samin50/MEngFYP/.kanbn/index.md

---
startedColumns:
  - 'In Progress'
completedColumns:
  - Done
defaultTaskWorkload: 0
taskWorkloadTags:
  Trivial: 0
  Tiny: 1
  Small: 2
  Medium: 3
  Large: 5
  Huge: 8
---

# Project Organisation

## Blocked

- [create-component-grouper](tasks/create-component-grouper.md)
- [create-component-value-identifier](tasks/create-component-value-identifier.md)
- [create-vision-system](tasks/create-vision-system.md)

## Todo

- [gather-components-training-data](tasks/gather-components-training-data.md)
- [design-new-camera-mount](tasks/design-new-camera-mount.md)

## In Progress

- [interim-report](tasks/interim-report.md)
- [create-conveyor-belt](tasks/create-conveyor-belt.md)
- [design-lcd-ui](tasks/design-lcd-ui.md)

## Done

- [build-stage-1-system](tasks/build-stage-1-system.md)
- [design-camera-mount](tasks/design-camera-mount.md)
- [design-lcd-mount](tasks/design-lcd-mount.md)
- [design-psu-mount](tasks/design-psu-mount.md)
- [determine-necessary-components](tasks/determine-necessary-components.md)
- [talk-with-lab-technicians](tasks/talk-with-lab-technicians.md)
- [create-vision-trainer](tasks/create-vision-trainer.md)
