samin50/MEngFYP/doc/Final Report/Appendix.tex

\newpage
\section{Appendix}
\label{sec:appendix}
\subsection{GitHub Repository}
\label{app:github}
The code and design files for this project can be found at the following link: \\
\url{https://github.com/samin50/MEngFYP}

\subsection{Raspberry Pi Benchmarking}
\begin{figure}[H]
  \centering
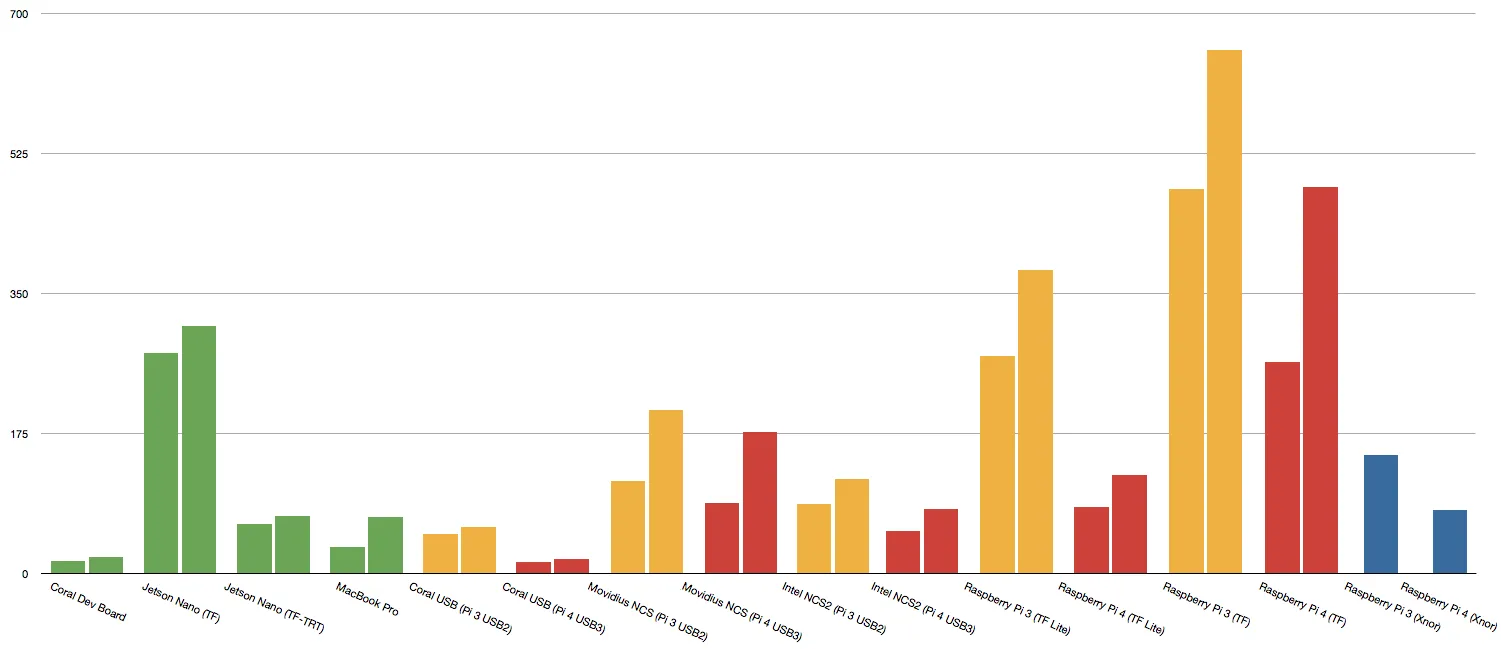
[picture p27: doc/Final Report/imgs/articles/benchmarks.png]
  
  \caption{Raspberry Pi Benchmarking}
  \label{app:benchmarking}
\end{figure}

\subsection{Component Detection Mosaic}
\begin{figure}[H]
  \centering
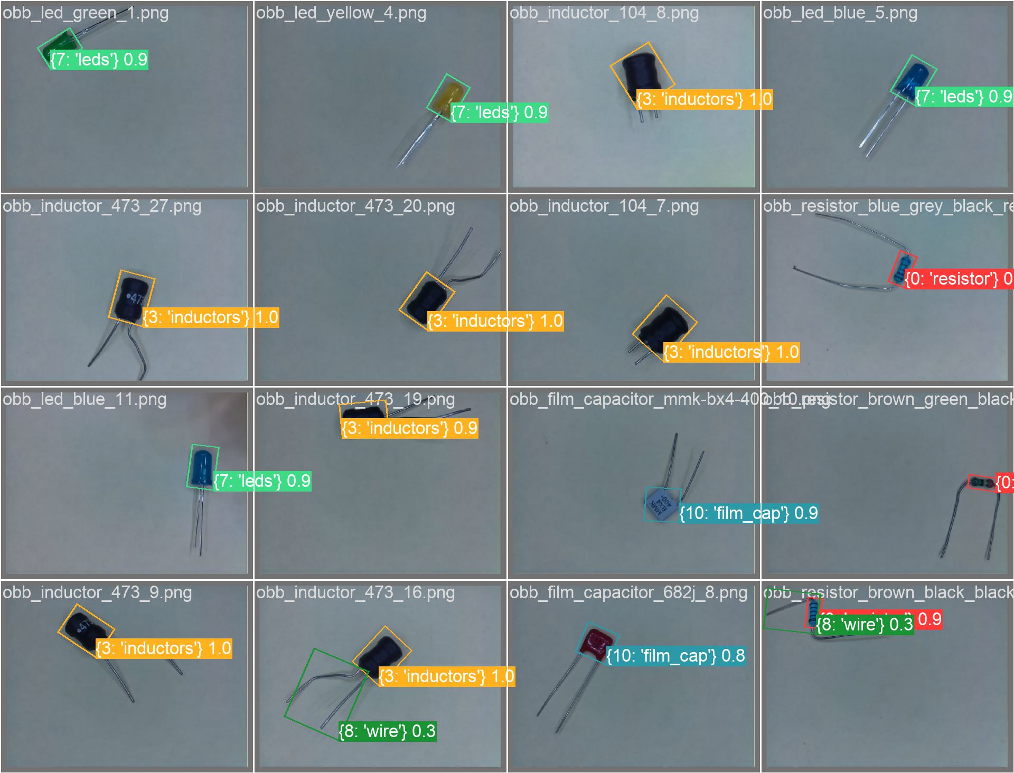
[picture p28: doc/Final Report/imgs/cv/val_batch1_pred.jpg]
  
  \caption{Component Detection Mosaic}
  \label{app:mosaic}
\end{figure}
