samin50/MEngFYP/.kanbn/tasks/design-camera-mount.md

---
created: 2023-12-18T02:33:51.351Z
updated: 2024-02-12T05:19:56.893Z
assigned: ""
progress: 1
tags:
  - 'Stage 1'
  - HME
  - Small
started: 2023-12-16T00:00:00.000Z
completed: 2023-12-18T00:00:00.000Z
---

# Design Camera Mount

Design the camera mount, contains the camera itself and the light ring.

## Relations

- [Succeeded by design-new-camera-mount](design-new-camera-mount.md)
