samin50/MEngFYP/.kanbn/tasks/design-lcd-mount.md

---
created: 2024-01-27T21:05:32.985Z
updated: 2024-02-12T05:20:50.158Z
assigned: ""
progress: 1
tags:
  - 'Stage 1'
  - HME
  - Small
started: 2023-12-18T00:00:00.000Z
completed: 2024-01-04T00:00:00.000Z
---

# Design LCD Mount
