samin50/MEngFYP/.kanbn/tasks/design-lcd-ui.md

---
created: 2024-02-13T02:04:30.207Z
updated: 2024-02-13T02:07:16.027Z
assigned: ""
progress: 0.4
tags:
  - 'All Stages'
  - Software
  - Huge
started: 2023-12-03T00:00:00.000Z
---

# Design LCD UI

Design the UI for the LCD

## Sub-tasks

- [x] Implement camera feed
- [x] System statistics
- [ ] Computer vision overlay
- [ ] Hardware control section

## Relations

- [Requires create-vision-system](create-vision-system.md)
