samin50/MEngFYP/.kanbn/tasks/design-new-camera-mount.md

---
created: 2024-02-12T03:16:14.948Z
updated: 2024-02-12T16:56:02.773Z
assigned: ""
progress: 0
tags:
  - 'Stage 2'
  - HME
  - Small
started: 2024-02-01T00:00:00.000Z
---

# Design New Camera Mount

Design the camera mount for the stage 2 conveyor belt system.

## Sub-tasks

- [ ] Design face-down mount
- [ ] Wire camera

## Relations

- [Requires create-conveyor-belt](create-conveyor-belt.md)
- [Replaces design-camera-mount](design-camera-mount.md)
