samin50/MEngFYP/.kanbn/tasks/design-psu-mount.md

---
created: 2024-01-27T21:03:12.771Z
updated: 2024-02-12T05:20:02.635Z
assigned: ""
progress: 1
tags:
  - 'Stage 1'
  - HME
  - Medium
started: 2023-12-18T00:00:00.000Z
completed: 2024-01-15T00:00:00.000Z
---

# Design PSU Mount
