samin50/MEngFYP/.kanbn/tasks/interim-report.md

---
created: 2023-12-18T02:38:25.647Z
updated: 2024-02-12T16:53:56.521Z
assigned: ""
progress: 0.8
tags:
  - 'Stage 1'
  - Logistics
  - Huge
due: 2024-02-13T00:00:00.000Z
started: 2023-11-01T00:00:00.000Z
---

# Interim Report

Complete the interim report

## Sub-tasks

- [x] Background Review
- [x] Implementation
- [x] Other sections
- [ ] Proof read

## Relations

- [Requires build-stage-1-system](build-stage-1-system.md)
