samin50/MEngFYP/.kanbn/tasks/create-conveyor-belt.md

---
created: 2024-02-12T02:47:56.086Z
updated: 2024-02-12T16:57:51.049Z
assigned: ""
progress: 0.4
tags:
  - 'Stage 2'
  - HME
  - Medium
started: 2024-02-09T00:00:00.000Z
---

# Create Conveyor Belt

Design the conveyor belt; use aluminium extrusion to form the frame and design 3D printed mounts for the motor and rollers. Integrate and wire the conveyor belt into the system.

## Sub-tasks

- [x] Design motor and idler mounts
- [ ] Design and fit rollers
- [ ] Wire electronics
- [ ] Integrate into system

## Relations

- [Requires build-stage-1-system](build-stage-1-system.md)
