samin50/MEngFYP/.kanbn/tasks/create-vision-system.md

---
created: 2023-11-07T21:32:41.515Z
updated: 2024-02-12T19:54:57.903Z
assigned: ""
progress: 0.1
tags:
  - 'Stage 2'
  - Vision
  - Huge
started: 2023-11-07T00:00:00.000Z
---

# Create Vision System

Create and train the two stage vision system required by the project

## Relations

- [Requires gather-components-training-data](gather-components-training-data.md)
- [Requires create-component-value-identifier](create-component-value-identifier.md)
- [Requires create-component-grouper](create-component-grouper.md)
- [Requires design-new-camera-mount](design-new-camera-mount.md)
- [Requires create-conveyor-belt](create-conveyor-belt.md)
