samin50/MEngFYP/.kanbn/tasks/talk-with-lab-technicians.md

---
created: 2024-02-12T03:18:52.675Z
updated: 2024-02-12T05:58:21.996Z
assigned: ""
progress: 1
tags:
  - 'Stage 1'
  - Logistics
  - Trivial
started: 2023-12-08T00:00:00.000Z
completed: 2024-02-12T00:00:00.000Z
---

# Talk with Lab Technicians

Talk with May in the Level 1 Lab to discuss the project.
