samin50/MEngFYP/doc/Final Report/Implementation.tex

\section{Implementation}
\label{sec:implementation}

This chapter discusses the implementation of the design that was discussed in \autoref{sec:design-and-system-architecture}, and the problems and changes that were encountered during the implementation process.

\subsection{Mechanical Design}
\label{sec:implementation-mechanical-design}
\include*{subpages/implementation/Mechanical Design}

\subsection{Electronics and Wiring}
\label{sec:electronics}
\include*{subpages/implementation/Electronics}

\subsection{Computer Vision}
\label{sec:computer-vision}
\include*{subpages/implementation/Computer Vision}  

\subsection{Software}
\label{sec:software}
\include*{subpages/implementation/Software}

\subsection{Problems and Changes}
\label{sec:implementation-problems-and-changes}
\include*{subpages/implementation/Problems}
