samin50/MEngFYP/.kanbn/tasks/create-vision-trainer.md

---
created: 2024-01-02T19:08:58.722Z
updated: 2024-02-13T02:01:46.170Z
assigned: ""
progress: 1
tags:
  - 'Stage 1'
  - Vision
  - Software
  - Large
started: 2024-01-01T00:00:00.000Z
completed: 2024-01-26T00:00:00.000Z
---

# Create Vision Trainer

Create Vision Trainer that will aid the process of developing datasets and training sets for the vision system.

## Relations

- [Requires gather-components-training-data](gather-components-training-data.md)
