samin50/MEngFYP/doc/Final Report/svg-inkscape/all_svg-tex.pdf

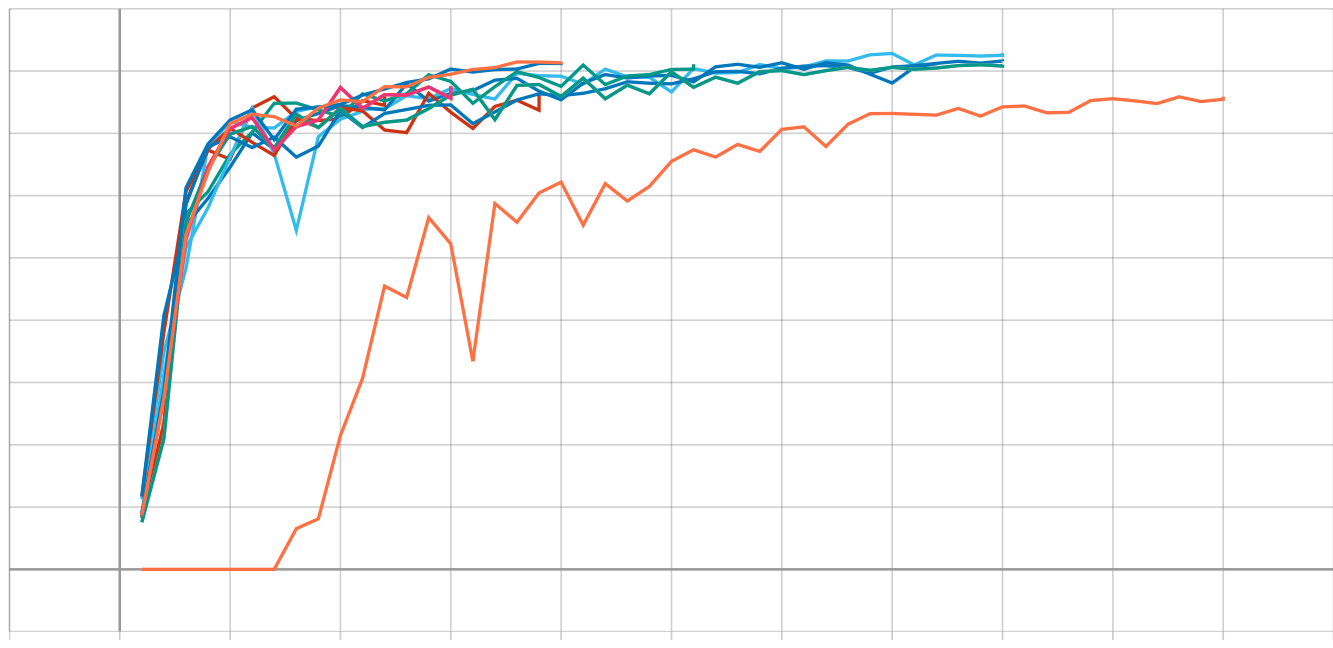
[picture p72: page 2]
