samin50/MEngFYP/doc/Final Report/svg-inkscape/finalmodelmap95_svg-tex.pdf

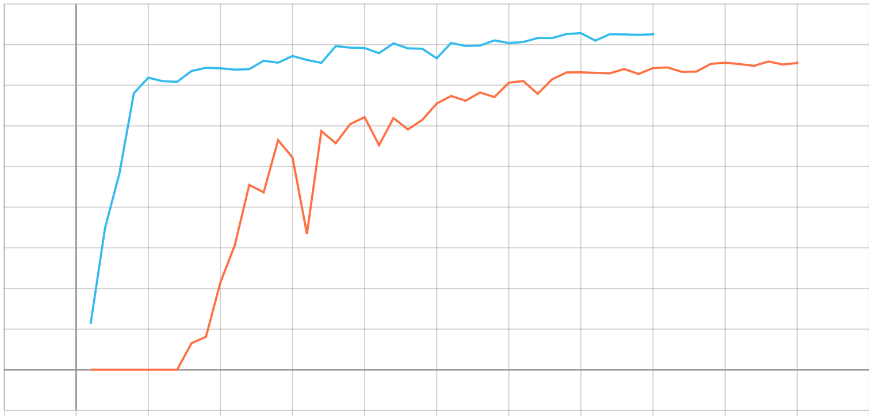
[picture p73: figure]
