samin50/MEngFYP/doc/Final Report/svg-inkscape/metrics_mAP50(B)_svg-tex.pdf

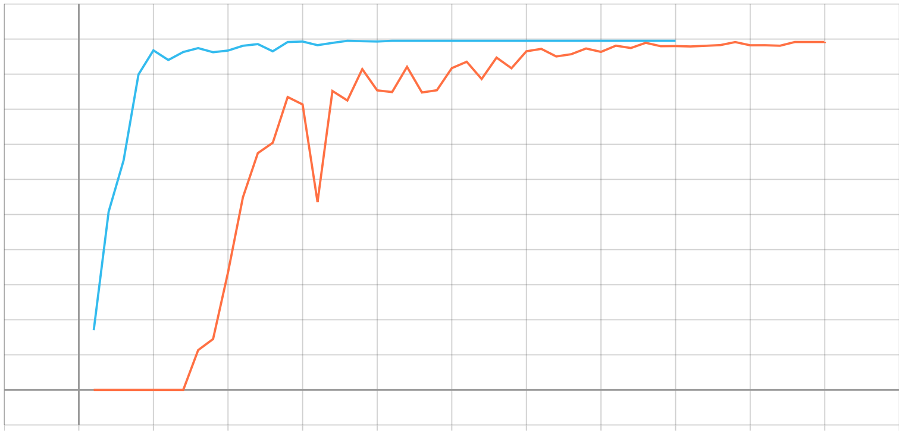
[picture p74: figure]
