samin50/MEngFYP/doc/Final Report/imgs/appendix/systemdesign.jpg

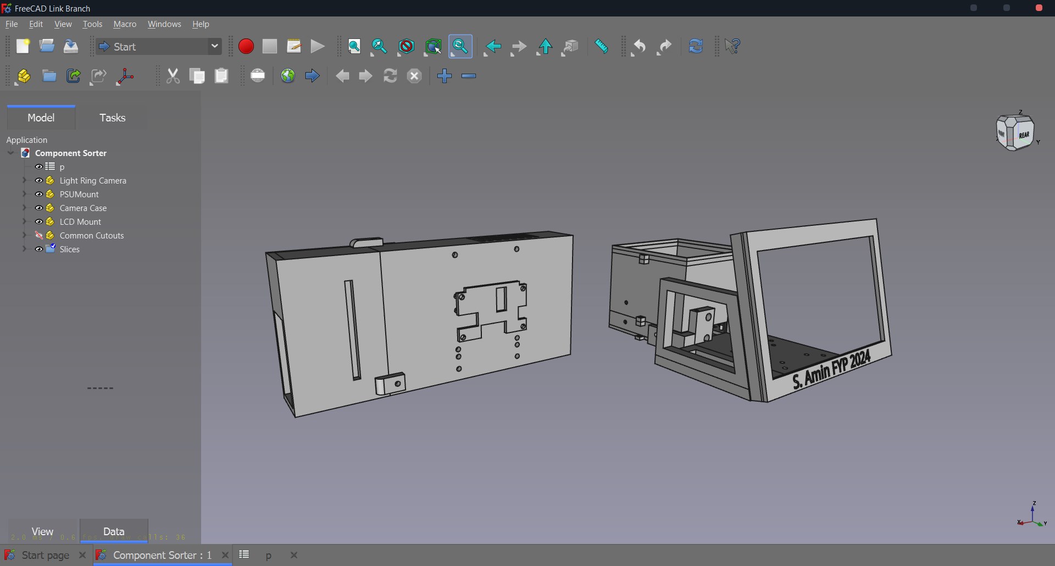
doc/Final Report/imgs/appendix/systemdesign.jpg
