samin50/MEngFYP/doc/Final Report/imgs/appendix/taskexample.jpg

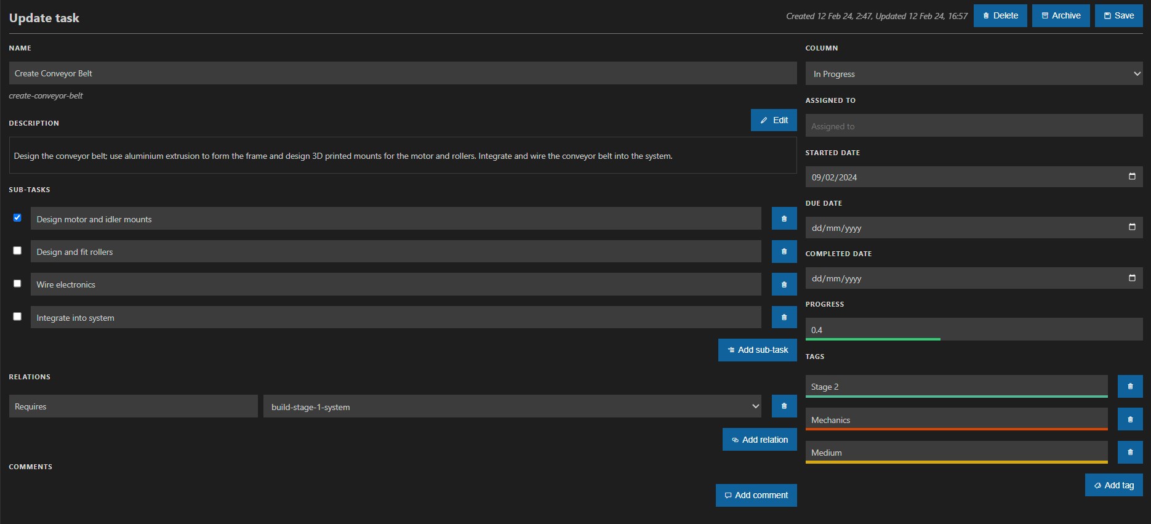
doc/Final Report/imgs/appendix/taskexample.jpg
