samin50/MEngFYP/doc/Final Report/imgs/design/allparts.jpeg

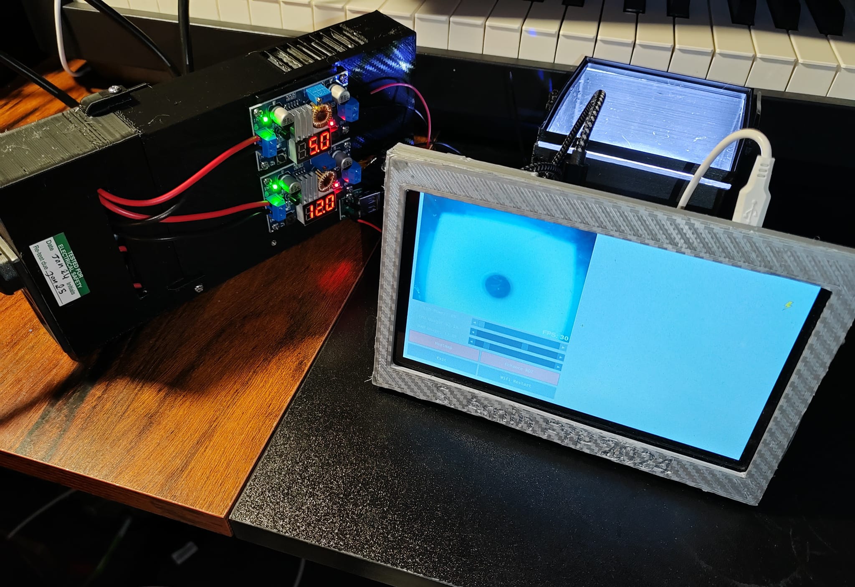
doc/Final Report/imgs/design/allparts.jpeg
