samin50/MEngFYP/doc/Final Report/imgs/freecad/camera_case.jpg

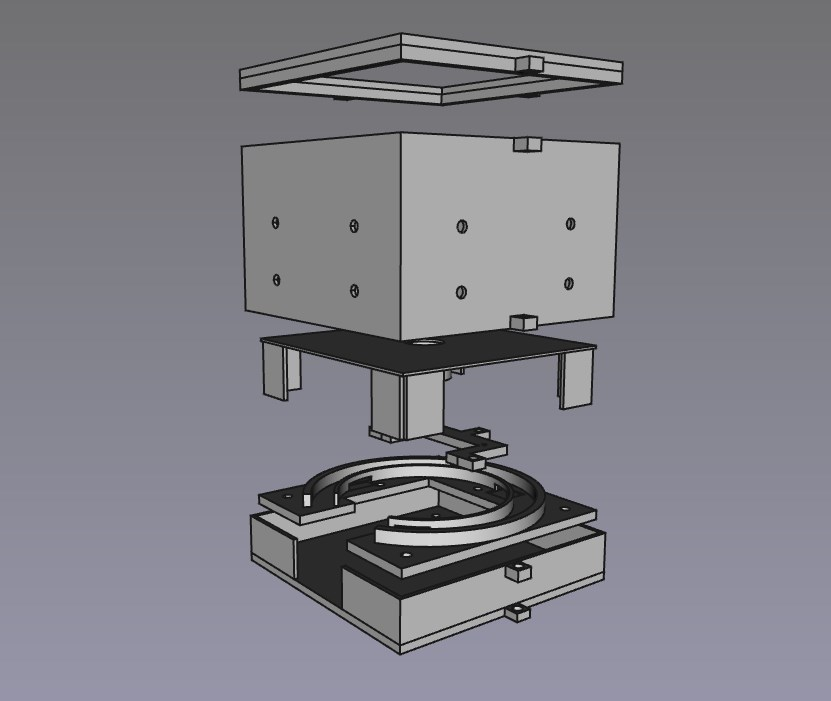
doc/Final Report/imgs/freecad/camera_case.jpg
