samin50/MEngFYP/doc/Final Report/imgs/freecad/lcd_mount.jpg

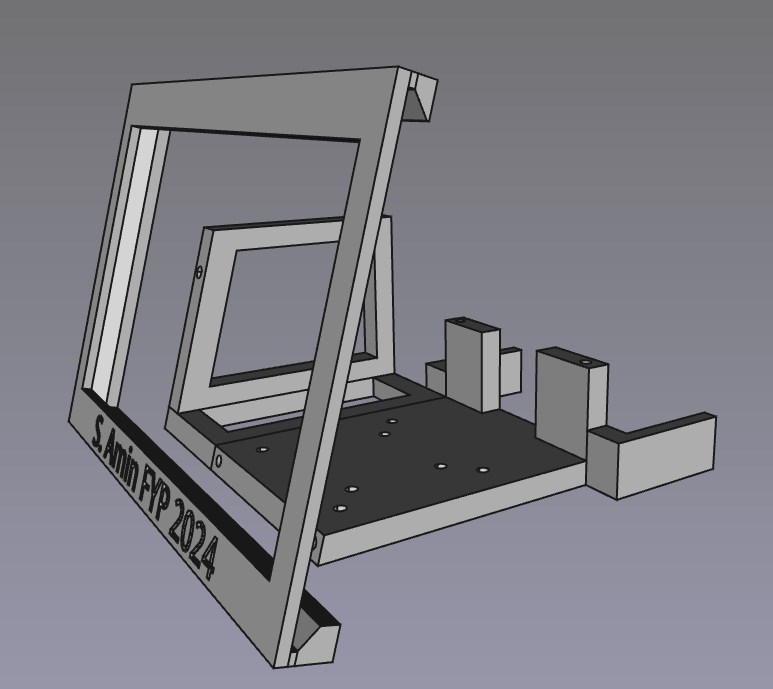
doc/Final Report/imgs/freecad/lcd_mount.jpg
