samin50/MEngFYP/doc/Final Report/imgs/freecad/psu_mount.jpg

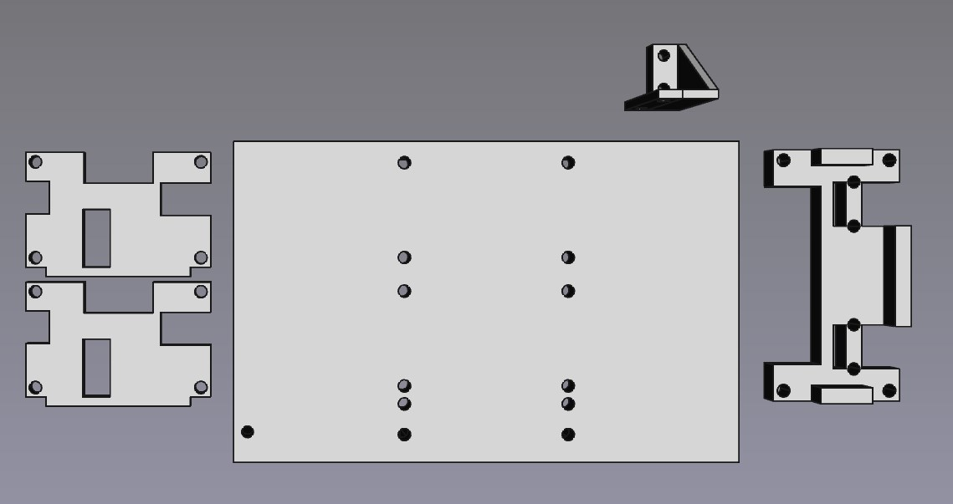
doc/Final Report/imgs/freecad/psu_mount.jpg
