samin50/MEngFYP/doc/Final Report/imgs/graphs/val_batch1_pred.jpg

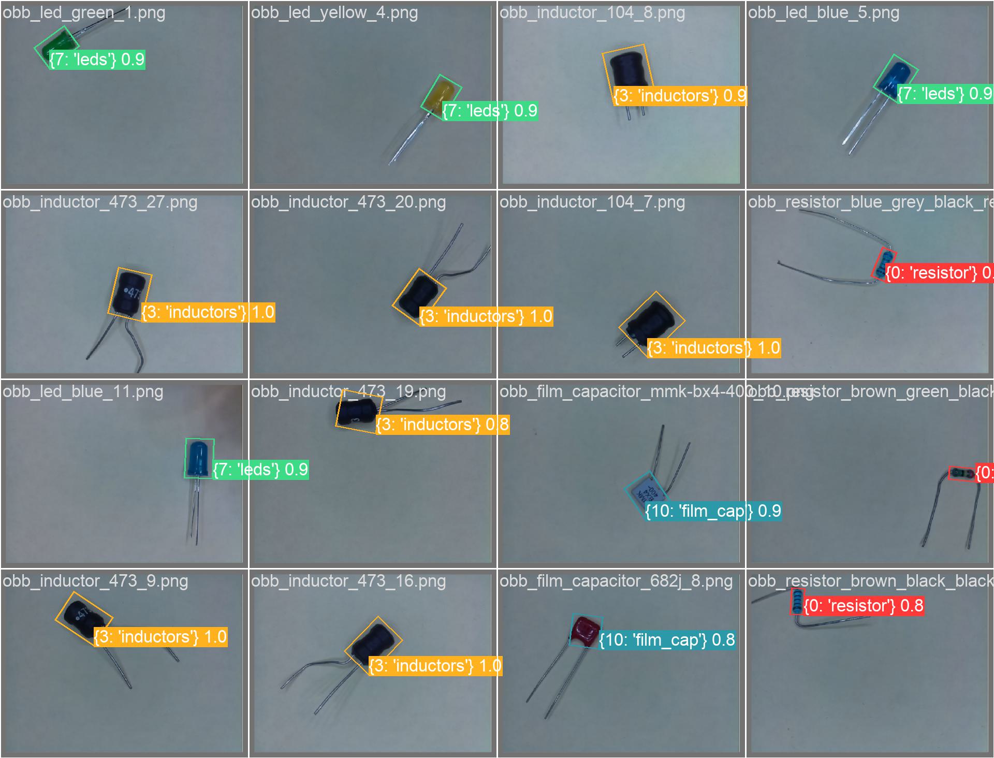
doc/Final Report/imgs/graphs/val_batch1_pred.jpg
