samin50/MEngFYP/doc/Final Report/imgs/pattesting.jpeg

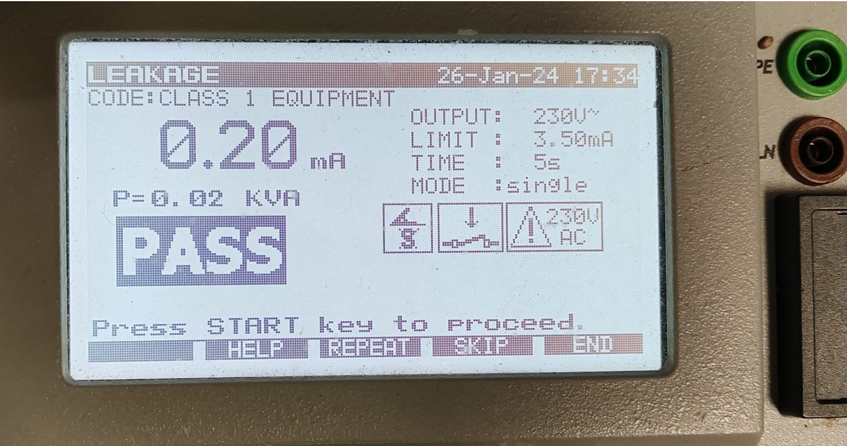
doc/Final Report/imgs/pattesting.jpeg
