samin50/MEngFYP/doc/Final Report/imgs/software/tools.png

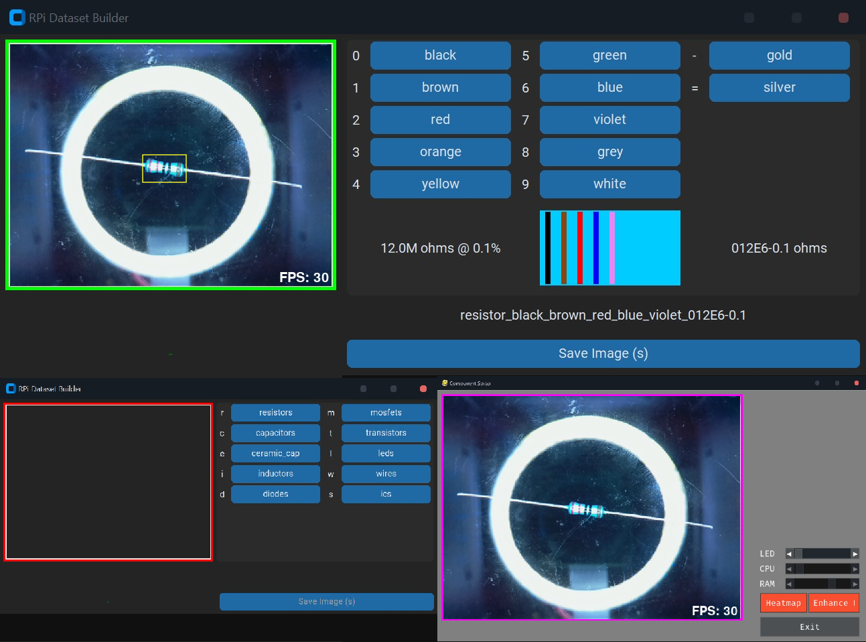
doc/Final Report/imgs/software/tools.png
