samin50/MEngFYP/src/pinout.png

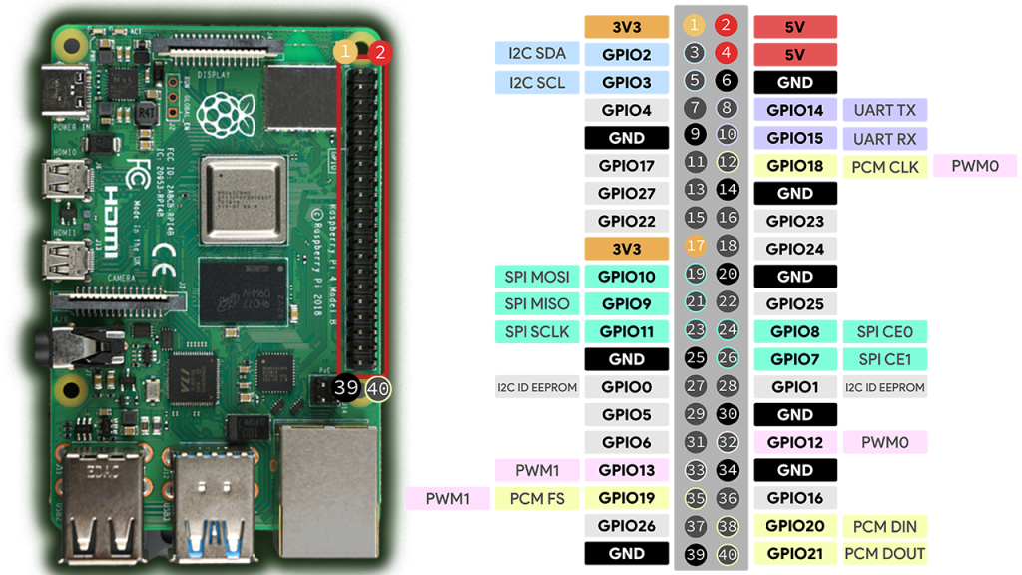
src/pinout.png
