samin50/MEngFYP/src/vision/confusion_matrix_bands.png

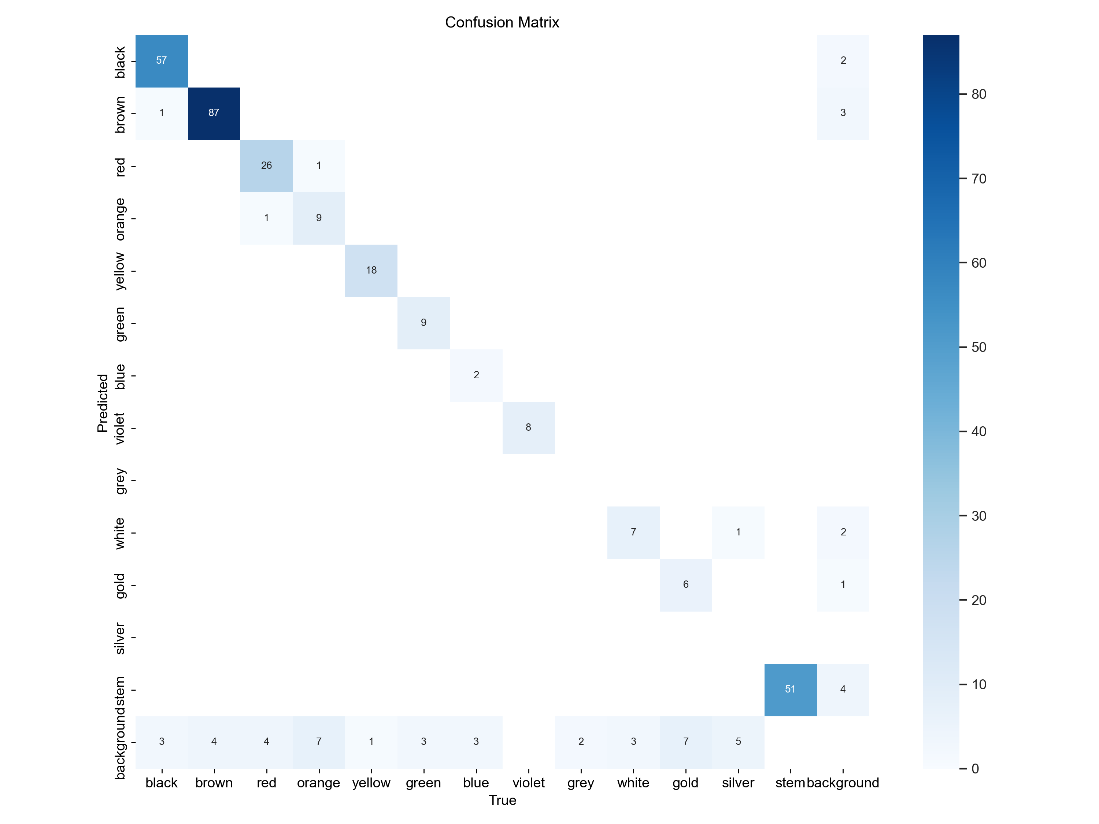
src/vision/confusion_matrix_bands.png
