samin50/MEngFYP/src/vision/confusion_matrix_normalized.png

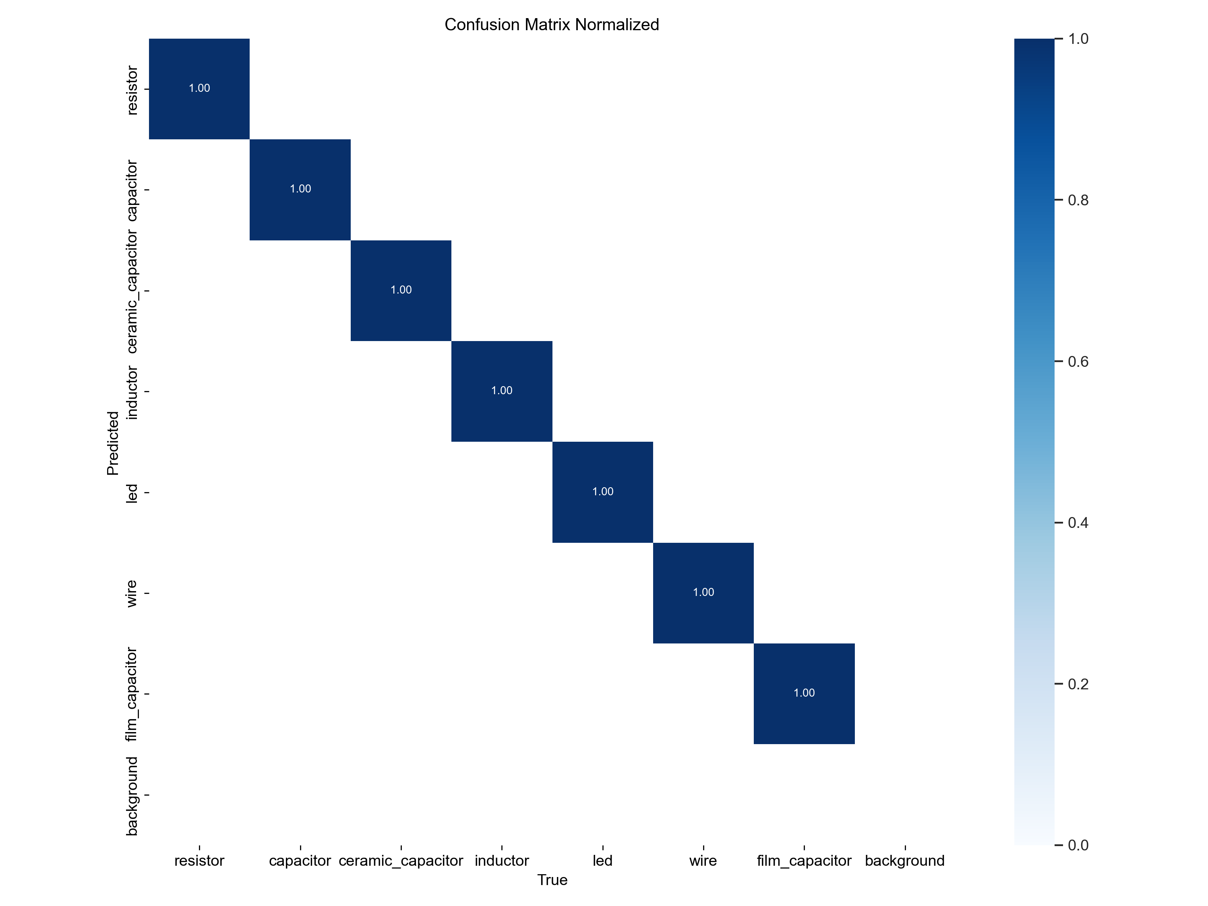
src/vision/confusion_matrix_normalized.png
