samin50/MEngFYP/.kanbn/tasks/create-component-grouper.md

---
created: 2023-11-07T21:41:04.194Z
updated: 2024-02-12T05:58:58.160Z
assigned: ""
progress: 0.2
tags:
  - 'Stage 2'
  - Vision
  - Medium
started: 2023-11-07T00:00:00.000Z
---

# Create Component Grouper

Create CV system to recognise a category of components to enable the next vision stage to correctly identify the component values

## Relations

- [Requires gather-components-training-data](gather-components-training-data.md)
