samin50/MEngFYP/.kanbn/tasks/create-component-value-identifier.md

---
created: 2023-11-07T21:42:18.879Z
updated: 2024-02-12T05:59:04.979Z
assigned: ""
progress: 0.2
tags:
  - 'Stage 2'
  - Vision
  - Large
started: 2023-11-07T00:00:00.000Z
---

# Create Component Value Identifier

Create vision system capable of identifying the value of the component in the image

## Sub-tasks

- [ ] Resistor Identifier
- [ ] Capacitor Identifer
- [ ] IC Identifer
- [ ] MOSFET Identifer

## Relations

- [Requires gather-components-training-data](gather-components-training-data.md)
