samin50/MEngFYP/.kanbn/tasks/determine-necessary-components.md

---
created: 2023-11-07T21:30:03.842Z
updated: 2024-02-12T05:20:58.108Z
assigned: ""
progress: 1
tags:
  - 'Stage 1'
  - Logistics
  - Small
started: 2023-11-07T00:00:00.000Z
completed: 2024-01-02T00:00:00.000Z
---

# Determine Necessary Components

Find the following components:

## Sub-tasks

- [x] Controller Board
- [x] Camera module
- [x] Flashlight/LED module
- [x] Acrylic Pane
- [x] Power Supply
