samin50/MEngFYP/.kanbn/tasks/gather-components-training-data.md

---
created: 2023-11-07T21:32:13.543Z
updated: 2024-02-12T05:18:26.292Z
assigned: ""
progress: 0
tags:
  - 'Stage 2'
  - Vision
  - Medium
started: 2023-11-07T00:00:00.000Z
---

# Gather Components Training Data

Gather images of training data for the following components:

## Sub-tasks

- [ ] Resistors
- [ ] Capacitors
- [ ] Mosfets
- [ ] ICs

## Relations

- [Requires design-new-camera-mount](design-new-camera-mount.md)
