samin50/MEngFYP/doc/BOM.xlsx

Category | Group | Usage | Component | Link | Price | Component Desc | Dependencies | Notes | Bought Batch 1 | Bought Batch 2 | Bought Batch 3 | Brought Myself | Totals | Batch 1: | =SUM(J2:J100)
Proccessing | Processors | Provides the system with real time computer vision capabilities |  |  |  |  |  |  |  |  |  |  |  | Batch 2: | =SUM(K2:K100)
 |  |  | Jetson Nano | https://uk.rs-online.com/web/p/processor-development-tools/1999831?gb=s | 134 | Possesses GPU, GPIO pins and CSI camera interface, can control the entire project
 |  |  | Raspberry Pi 4B 4GB | https://onecall.farnell.com/raspberry-pi/rpi4-modbp-4gb/raspberry-pi-4-model-b-4gb/dp/3051887 | 45 | Raspberry Pi to handle the system, possess USB ports, GPIO, CSI Camera. May need a seperate GPU for inferencing | RPI | Got a 2GB model instead | 45.46 |  |  |  |  | Myself: | =SUM(M2:M100)
 |  |  | Okdo ROCK 4 Model C+ | https://uk.rs-online.com/web/p/rock-sbc-boards/2493158 | 45 | RPi alternative with all the same inputs and outputs |  |  |  |  |  |  |  |  | =SUM(Q1:Q5)
 | GPU Processor | Seperate modules that provide AI inferencing capabilities
 |  |  | Intel Neural Compute Stick | https://uk.rs-online.com/web/p/processor-development-tools/1393655?gb=s | 59 | Provides real time inferencing capabilties to the raspberry pi | RPI
Vision | CSI Camera | Camera used for the visionn system
 |  |  | OV5647 Camera Adjustable Focus | https://www.aliexpress.com/item/1005003386791483.html?curPageLogUid=gnYNy1UG26o0 | 6 | Adjustable focus camera, allows for macro shots | CAM | Used here: https://www.instructables.com/RPi-MacroScope/
 |  |  | Okdo OV5647 Adjustable Focus | https://uk.rs-online.com/web/p/raspberry-pi-cameras/2020456 | 9.83 | ^^ | CAM |  | 9.83
 |  |  | IMX327LQR Adjustable Focus |  | 45 | ^^ | CAM
 |  |  | Ribbon Extension Cable | https://onecall.farnell.com/pro-signal/ctlcamcableassy-300mm/cable-for-pi-camera-300mm-formed/dp/SC13282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 | 1.20 | 300mm cable |  |  | 1.19 |  |  | 2.20
 |  |  | SD Card | https://onecall.farnell.com/integral/inmsdh32g10-sec/microsdhc-security-32gb/dp/MD01443?st=uhs-i | 8.30 | 32GB UHS-I U1 V10 |  |  | 8.30
 |  |  | LED Ring | https://www.aliexpress.com/item/4000212049737.html?curPageLogUid=UuRZStryj55u | 3.40 | 80mm 12V LED Ring for illumination 2pc |  |  |  |  |  | 6.00
Components | PSU | Power Supply Unit
 |  |  | 24V 150W Switching Power Supply | https://uk.rs-online.com/web/p/switching-power-supplies/2411652?gb=s | 20 | 150W |  |  | 19.38
 |  |  | C14 IEC20 Connector | https://uk.rs-online.com/web/p/iec-connectors/8117216 | 3.71 | 2pc |  |  |  | 7.42
 |  |  | IEC C13 Socket to Type G UK Plug | https://uk.rs-online.com/web/p/power-cords/1469109?gb=s | 4.46 | 1.8m |  |  |  | 4.46
 |  |  | 6A T Glass Cartridge Fuse, 5 x 20mm | https://uk.rs-online.com/web/p/cartridge-fuses/9113427?gb=s | 0.333 | 10pc |  |  |  | 3.33
 | Cables | Connect Components
 |  |  | 4 Way USB Hub | https://onecall.farnell.com/dynamode/usb3-hb-4pm-v2/hub-4-port-usb-a-to-4-x-usb-a/dp/CS35947 | 8.99 | 3pc |  |  |  | 8.99
 |  |  | USB A to USB C 3pc | https://onecall.farnell.com/newlink/nlmob-941bdbk/lead-usb2-0-a-c-m-m-black-braided/dp/CS35766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 | 6.42 | 3pc |  |  |  | 6.42
 |  |  | USB A to Micro B 3pc | https://onecall.farnell.com/pro-signal/psg91471/lead-usb2-0-a-male-micro-b-male/dp/3498532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 | 5.94 | 3pc |  |  |  | 5.94
 |  |  | USB C to C | https://onecall.farnell.com/pro-signal/psg91210/lead-usb2-0-type-c-type-c-1m-black/dp/CS28720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 | 3.61 | 1pc |  |  |  | 3.61
 |  |  | 18 awg red | https://uk.rs-online.com/web/p/hook-up-wire/8114422?gb=s | 10.27 | 25m |  |  | 10.27
 |  |  | 18 awg black | https://uk.rs-online.com/web/p/hook-up-wire/8114416?gb=s | 10.27 | 25m |  |  |  | 10.27
 |  |  | Ribbon cables 28 awg | https://uk.farnell.com/pro-power/r2651dtsy10ac85/ribbon-cable-10-core-28awg-per/dp/2628358 | 4.82 | 6m |  |  |  | 4.82
 |  |  | Wire stripper | https://uk.farnell.com/duratool/d03004/stripper-cutter-5-black-red/dp/2543007 | 2.15 | 1pc |  |  | 2.15
 |  |  | Micro HDMI to HDMI | https://uk.rs-online.com/web/p/hdmi-cables/1828766?gb=s | 5.56 | 2m |  |  | 5.56
 |  |  | Heatshrink | https://uk.farnell.com/pro-power/pp3021/heatshrink-sleeving-kit-2-1-blk/dp/4161511?st=shrink%20tubing%20set | 8.45 | 150pc |  |  | 8.45
 | Boards | Allow prototyping by placing components on a board
 |  |  | 150 Point Through Hole | https://onecall.farnell.com/proto-advantage/sbbth1510-1/solder-breadboard-150-holes/dp/PC02483 | 5.97 | 3pc |  |  |  | 5.97
 |  |  | Breadboard Small | https://onecall.farnell.com/cyntech/breadboard170red/breadboard-mini-red/dp/PC01594 | 4.11 | 3pc |  |  |  | 4.11
 | Connectors | Connect wires or components to each other
 |  |  | Ring terminal | https://uk.farnell.com/multicomp/crs-to-1806/terminal-ring-tongue-6-crimp/dp/1878197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 | 3.38 | 20pc |  |  | 3.38
 |  |  | JST Female Connectors | https://uk.rs-online.com/web/p/circular-connector-contacts/6027900?gb=s | 4.70 | 50pc |  |  | 4.70
 |  |  | JST Male Connectors | https://uk.rs-online.com/web/p/crimp-contacts/1613367?gb=s | 3.40 | 100pc |  |  | 3.40
 |  |  | Wire to board screw terminal single | https://uk.farnell.com/multicomp/mc000017/terminal-block-wire-to-brd-1pos/dp/2007984?st=screw%20terminal | 8.12 | 20pc |  |  | 8.12
 |  |  | USB Female Breakout | https://onecall.farnell.com/clever-little-box/cie-yy24/usb-2-0-a-socket-breakout-board/dp/CN22556 | 5.10 | 5pc |  |  |  | 5.10
 | Electronics | IRF520N
 |  |  | N Channel Mosfet to allow the Pi to control high voltage or high current components | https://onecall.farnell.com/vishay/irf520pbf/mosfet-n-100v-9-2a-to-220/dp/8648239?st=irf520 | 6.10 | 5pc |  |  |  | 6.10
 | Transformers | Step down voltage
 |  |  | 24V 5A Max | https://www.aliexpress.com/item/1005006174030695.html?curPageLogUid=pZiqGrlJTVoB | 9 | 5 pc
Screen | HDMI Screen | Display output using HDMI Connection
 |  |  | DFROBOT DFR0506 | https://onecall.farnell.com/dfrobot/dfr0506/hdmi-display-embedded-dev-board/dp/3517851?st=hdmi%20screen | 65 | 7 Inch |  |  | 65.29
Materials | PETG | Prototyping | Solid Grey | https://3dfilaprint.com/product/esun-petg-solid-grey-1-75mm-1kg-3d-printing-filament/ | 16 | 1kg |  |  | 16
 |  |  | Solid Black | https://3dfilaprint.com/product/esun-petg-solid-black-1-75mm-1kg-3d-printing-filament/ | 16 | 1kg |  |  | 16
 | Clear Plastic | For camera enclosure | Clear | https://uk.rs-online.com/web/p/plastic-sheets/0434295?gb=s | 13.03 | 500x300x3mm |  |  | 13.03
