samin50/MEngFYP/doc/Final Report/imgs/appendix/bom.jpg

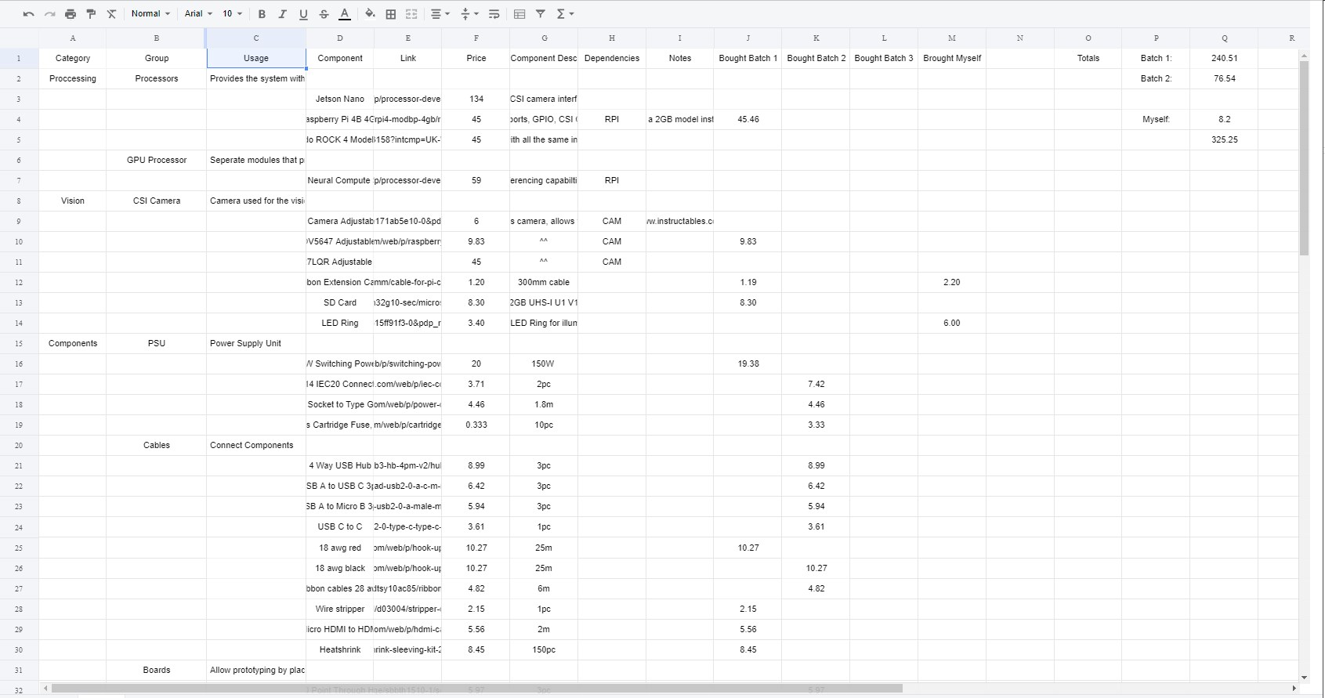
doc/Final Report/imgs/appendix/bom.jpg
