samin50/MEngFYP/doc/Final Report/imgs/parts/tmc2209.jpg

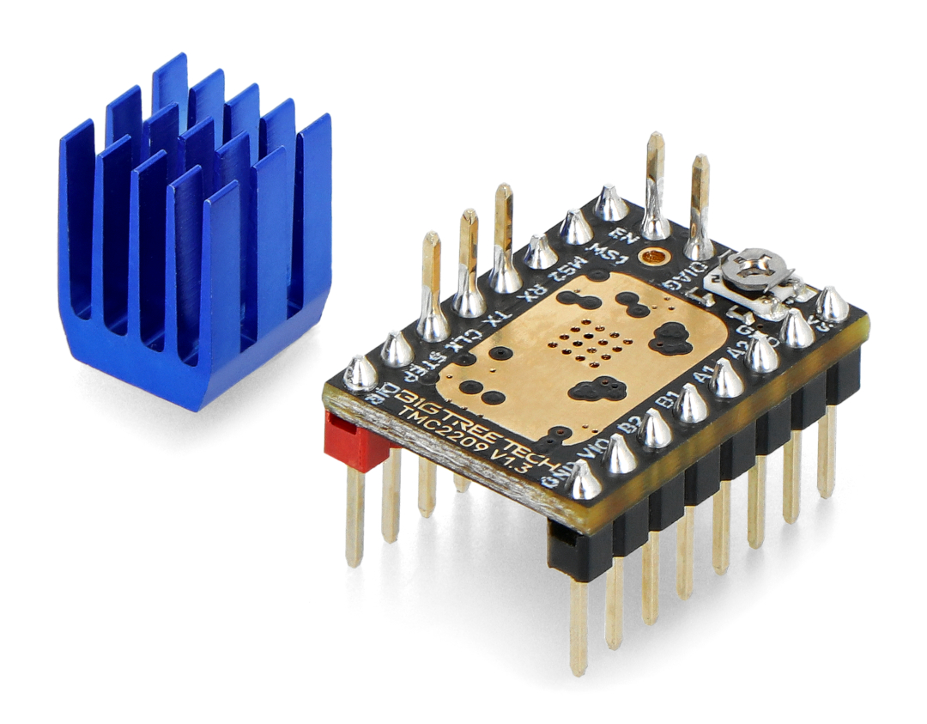
doc/Final Report/imgs/parts/tmc2209.jpg
