samin50/MEngFYP/design/FreeCAD/Bin Sorter/Bin/Bin Extrusion Mount.stl

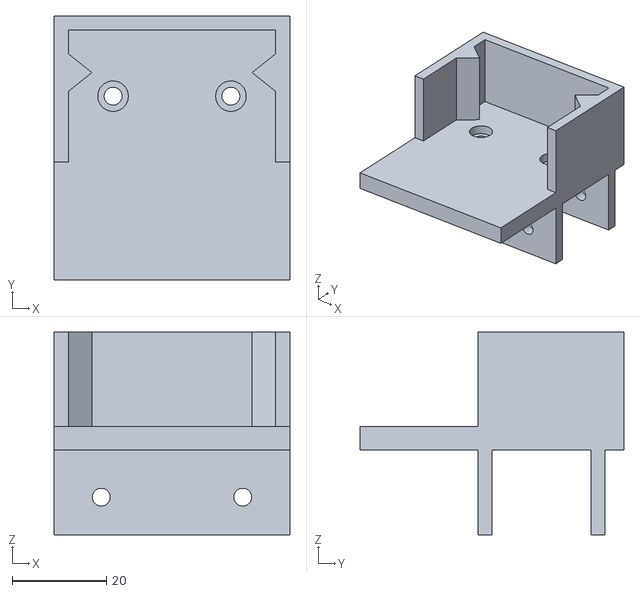
[picture p89: CAD file, 2024-06-09]
design/FreeCAD/Bin Sorter/Bin/Bin Extrusion Mount.stl
50.0 x 56.0 x 43.0
