samin50/MEngFYP/design/FreeCAD/Bin Sorter/Motor Mount.stl

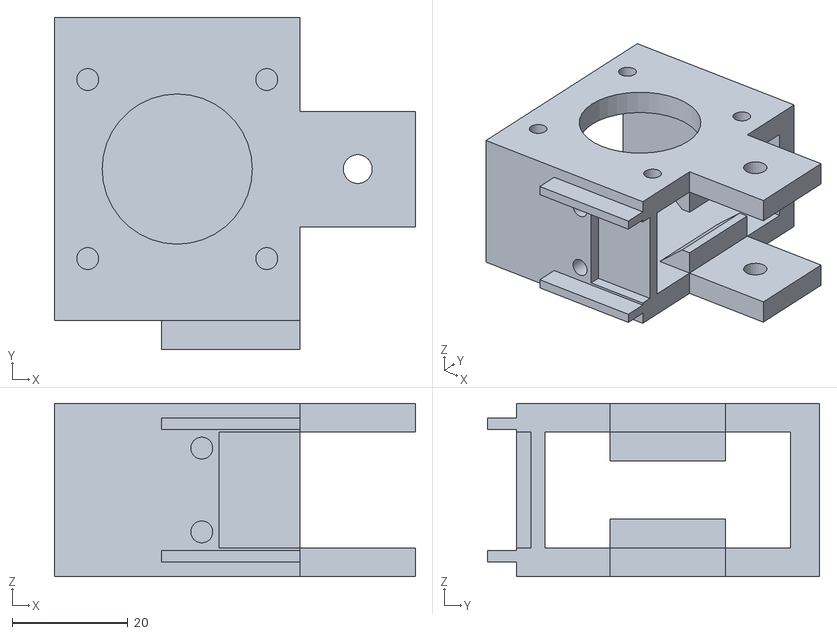
[picture p90: CAD file, 2024-06-17]
design/FreeCAD/Bin Sorter/Motor Mount.stl
62.5 x 57.5 x 30.0
