samin50/MEngFYP/design/FreeCAD/Bin Sorter/Sweeper/Rail.stl

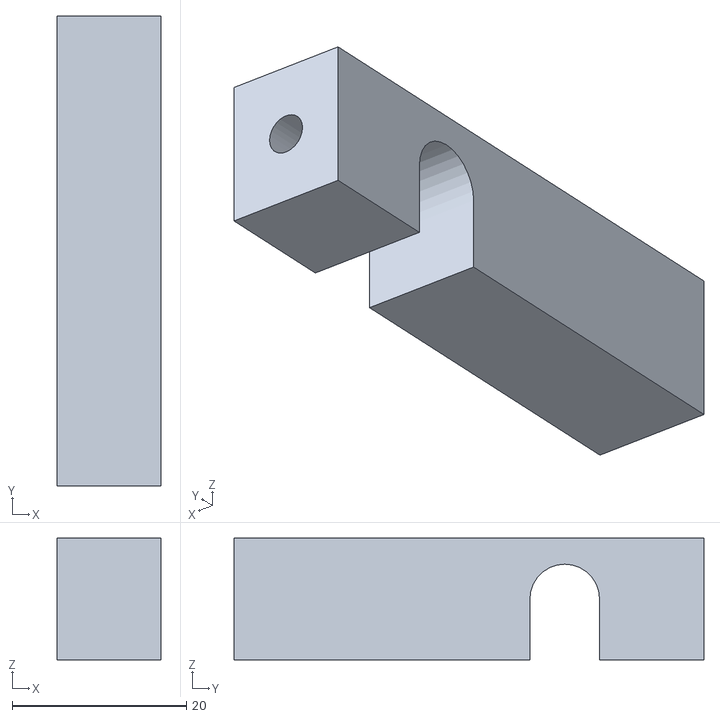
[picture p91: CAD file, 2024-05-17]
design/FreeCAD/Bin Sorter/Sweeper/Rail.stl
12.0 x 54.0 x 14.0
