samin50/MEngFYP/design/FreeCAD/Camera Mount/Mount Plate.stl

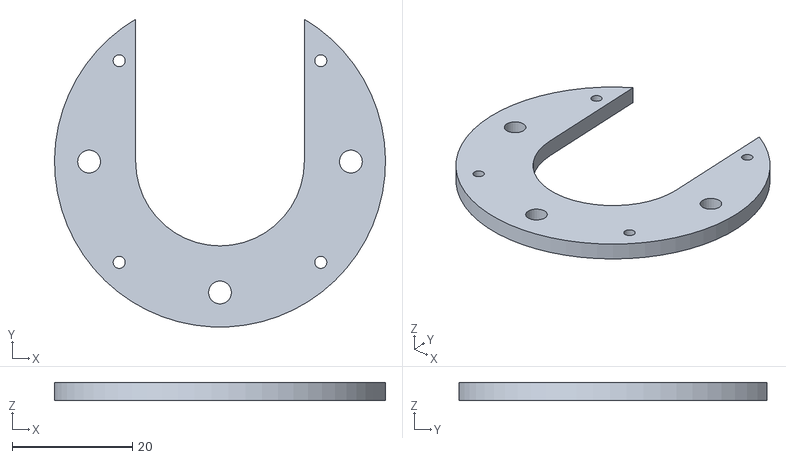
[picture p92: CAD file, 2024-06-14]
design/FreeCAD/Camera Mount/Mount Plate.stl
55.0 x 51.1 x 3.00
