samin50/MEngFYP/design/FreeCAD/Component Sorter.FCStd

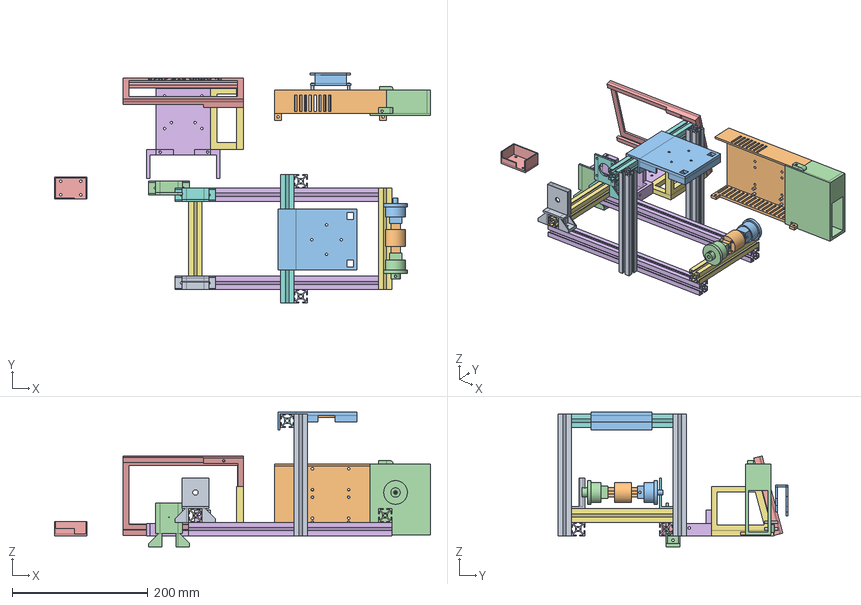
[picture p93: CAD file, 2024-05-03]
design/FreeCAD/Component Sorter.FCStd
555.0 x 340.0 x 199.2 mm
Screw Cut Out
ContainerWithCutout
Step Down Cover
Power Switch
Screen Cover
Screen + Cutout
Screen Support Tri
Motorside
Nonmotor
Inner Roller
Idle End Adapter
Motor Coupler
Motor Controller
newhor
newhor2
newhor3
vert
Camera Plate
Camera Box 2
ShapeBinder (Mirror #1)
