samin50/MEngFYP/design/FreeCAD/Conveyor/Motor Non Driven B.stl

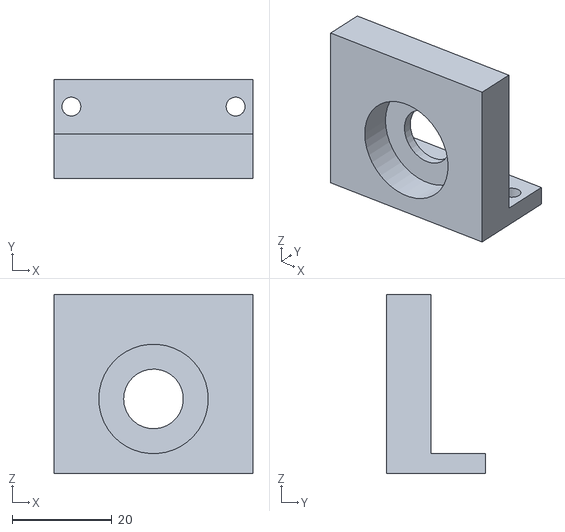
[picture p94: CAD file, 2024-06-03]
design/FreeCAD/Conveyor/Motor Non Driven B.stl
40.0 x 20.0 x 36.0
