samin50/MEngFYP/design/FreeCAD/Conveyor/Rollers/Idle End Adapter.stl

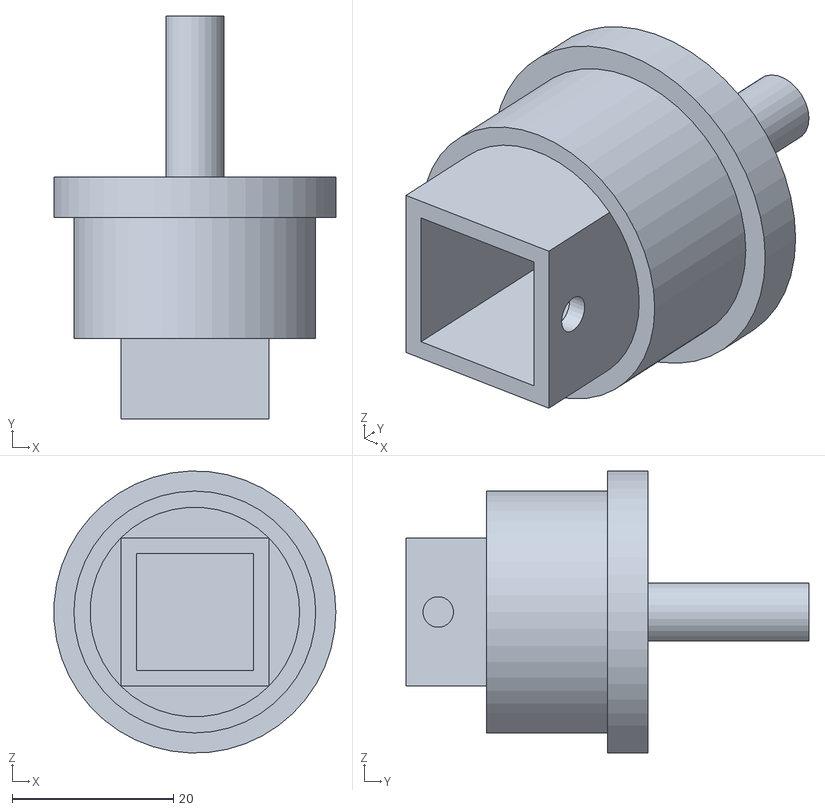
[picture p95: CAD file, 2024-05-01]
design/FreeCAD/Conveyor/Rollers/Idle End Adapter.stl
35.0 x 50.0 x 35.0
