samin50/MEngFYP/design/FreeCAD/LCD/Screen Support.stl

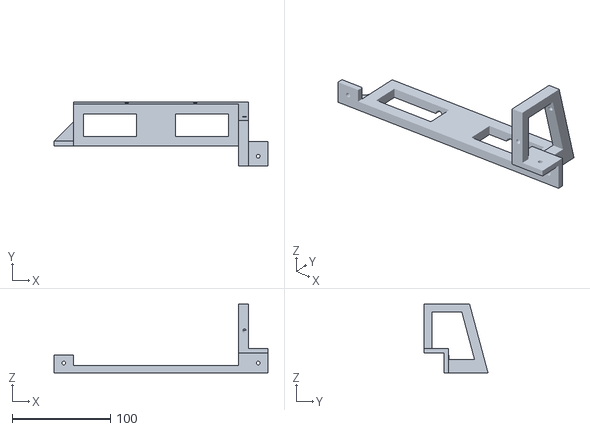
[picture p96: CAD file, 2024-06-03]
design/FreeCAD/LCD/Screen Support.stl
218.0 x 65.3 x 70.0
