samin50/MEngFYP/design/FreeCAD/PSU/USB Ports.stl

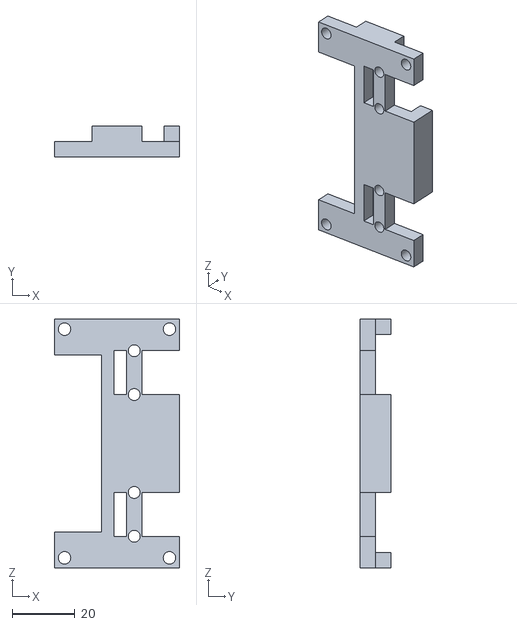
[picture p97: CAD file, 2024-05-30]
design/FreeCAD/PSU/USB Ports.stl
40.0 x 10.0 x 79.5
