samin50/MEngFYP/design/FreeCAD/Bin Sorter/Bin/Bin Container.stl

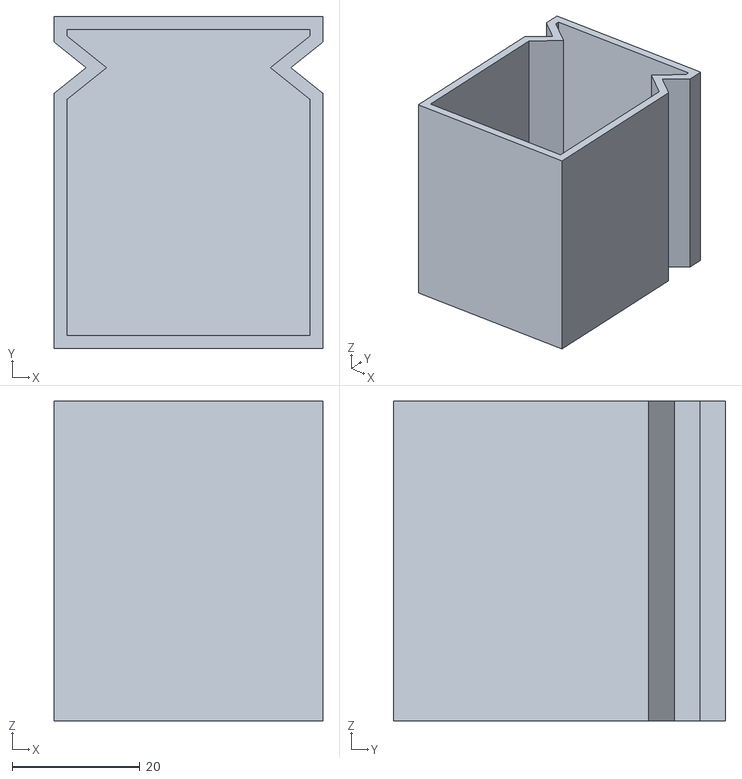
[picture p98: CAD file, 2024-06-09]
design/FreeCAD/Bin Sorter/Bin/Bin Container.stl
42.0 x 51.9 x 50.0
