samin50/MEngFYP/design/FreeCAD/Bin Sorter/Gantry.stl

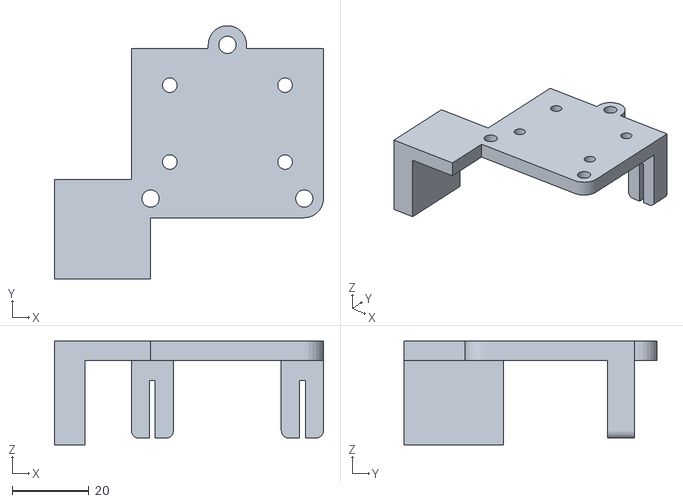
[picture p99: CAD file, 2024-06-17]
design/FreeCAD/Bin Sorter/Gantry.stl
70.0 x 66.0 x 27.0
