samin50/MEngFYP/design/FreeCAD/Bin Sorter/Sweeper/Container.stl

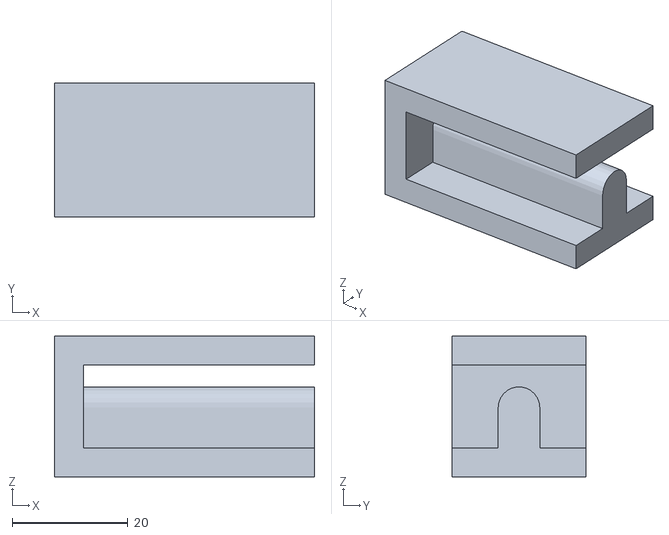
[picture p100: CAD file, 2024-05-17]
design/FreeCAD/Bin Sorter/Sweeper/Container.stl
45.0 x 23.2 x 24.4
