samin50/MEngFYP/design/FreeCAD/Camera Mount/Camera Box.stl

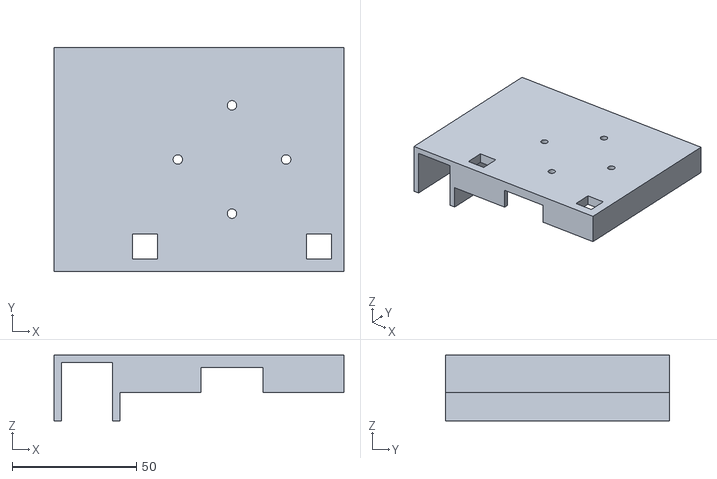
[picture p101: CAD file, 2024-06-13]
design/FreeCAD/Camera Mount/Camera Box.stl
116.5 x 90.0 x 26.5
