samin50/MEngFYP/design/FreeCAD/Conveyor/Motor Non Driven A.stl

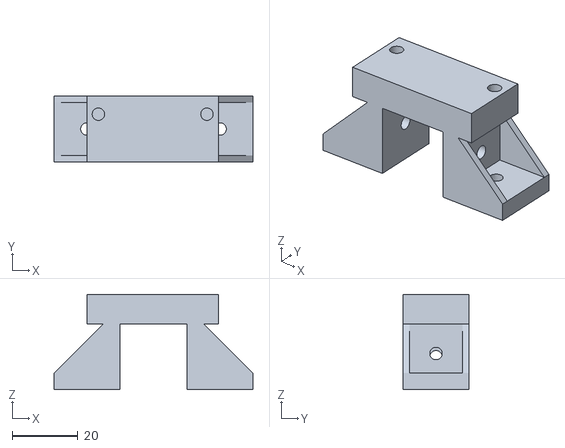
[picture p102: CAD file, 2024-06-03]
design/FreeCAD/Conveyor/Motor Non Driven A.stl
60.5 x 20.0 x 29.0
