samin50/MEngFYP/design/FreeCAD/Conveyor/Rollers/Motor Coupler.stl

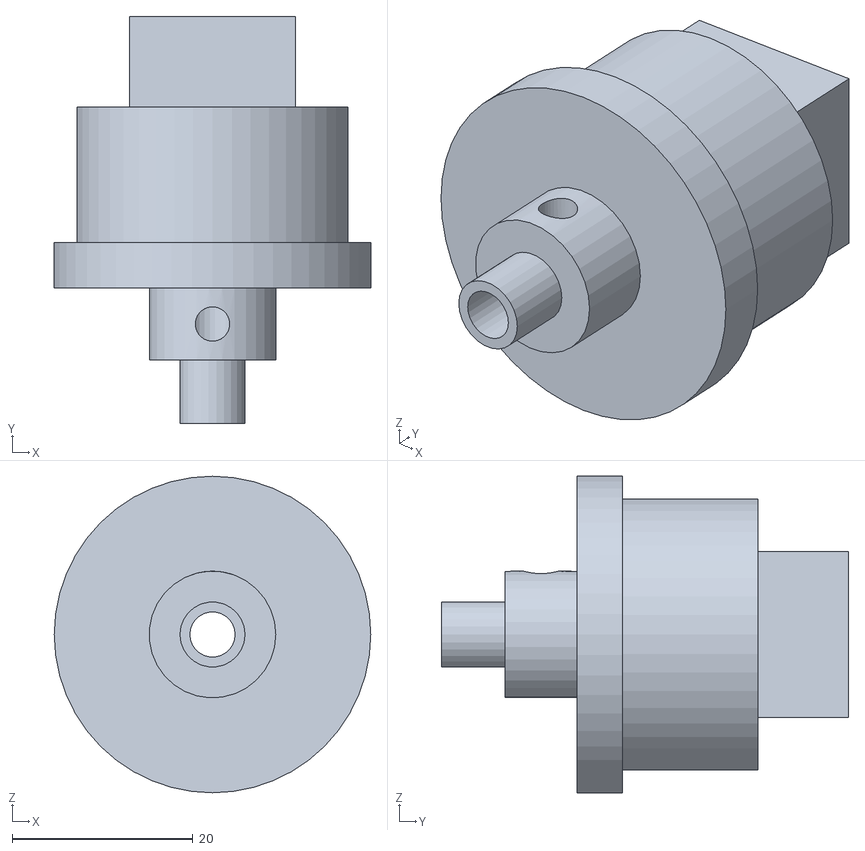
[picture p103: CAD file, 2024-04-30]
design/FreeCAD/Conveyor/Rollers/Motor Coupler.stl
35.0 x 45.0 x 35.0
