samin50/MEngFYP/design/FreeCAD/LCD/Screen Cover.stl

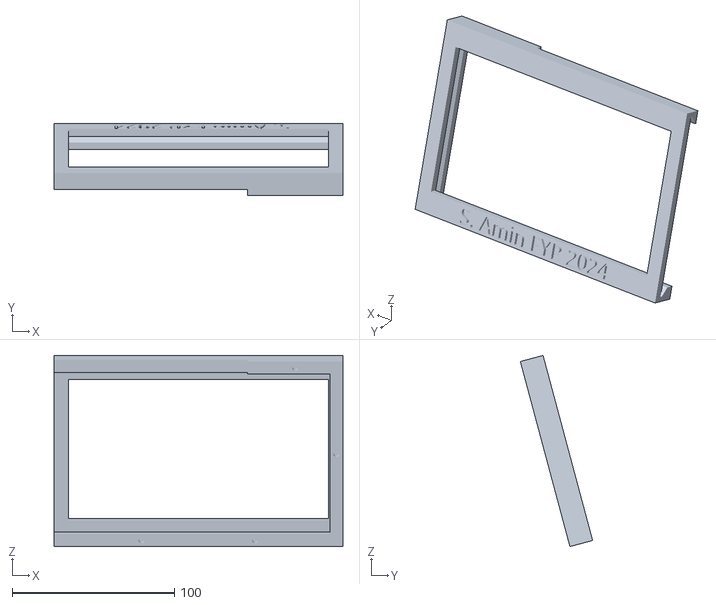
[picture p104: CAD file, 2024-05-30]
design/FreeCAD/LCD/Screen Cover.stl
178.0 x 44.5 x 117.7
