samin50/MEngFYP/design/FreeCAD/PSU/Extrusion Mount.stl

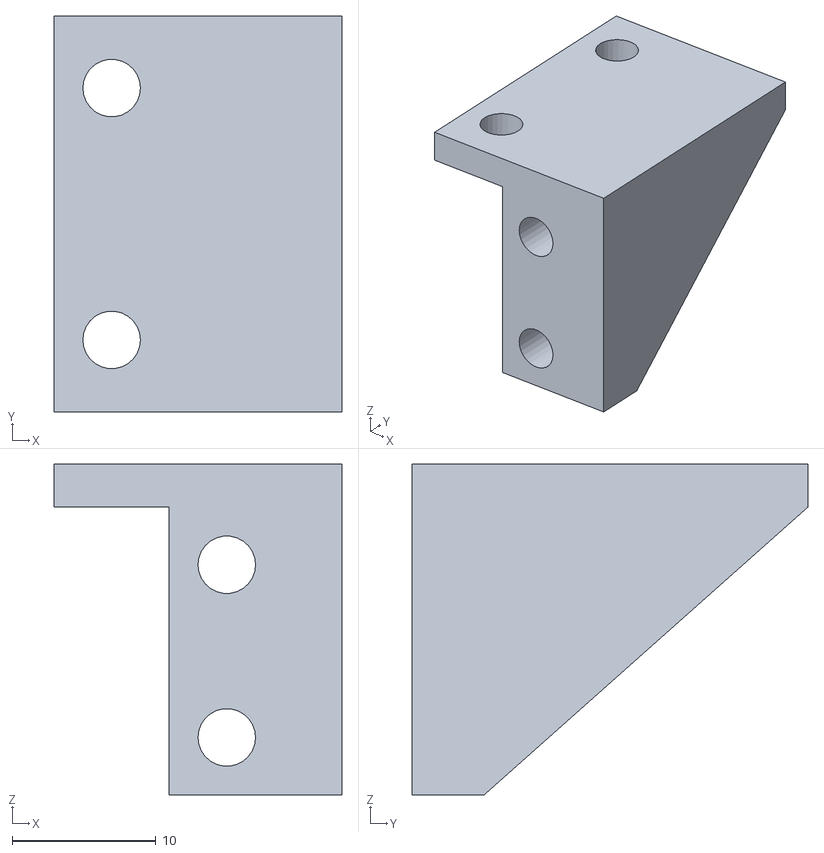
[picture p105: CAD file, 2024-05-30]
design/FreeCAD/PSU/Extrusion Mount.stl
20.0 x 27.5 x 23.0
