samin50/MEngFYP/design/FreeCAD/Bin Sorter/Sweeper/Blocker.stl

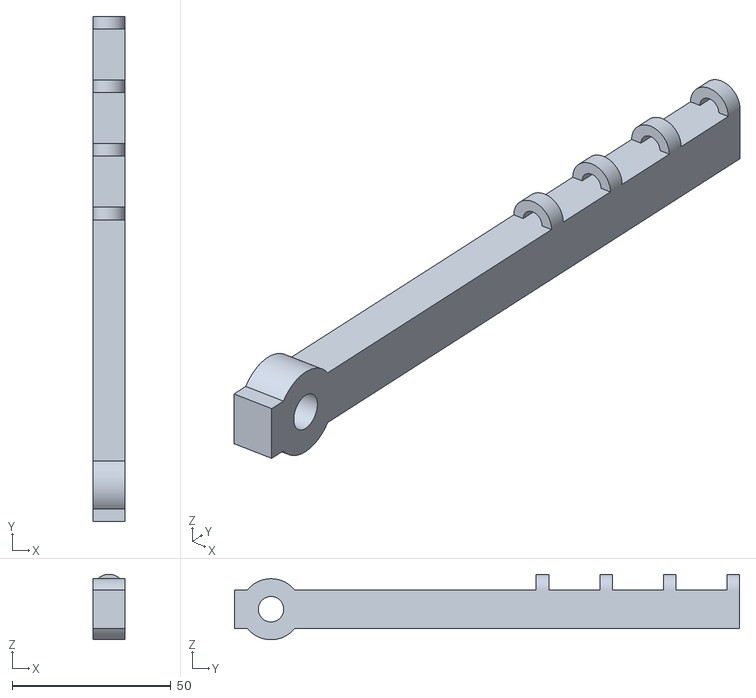
[picture p106: CAD file, 2024-05-17]
design/FreeCAD/Bin Sorter/Sweeper/Blocker.stl
10.0 x 159.0 x 20.6
