samin50/MEngFYP/design/FreeCAD/Bin Sorter/Tensioner Mount.stl

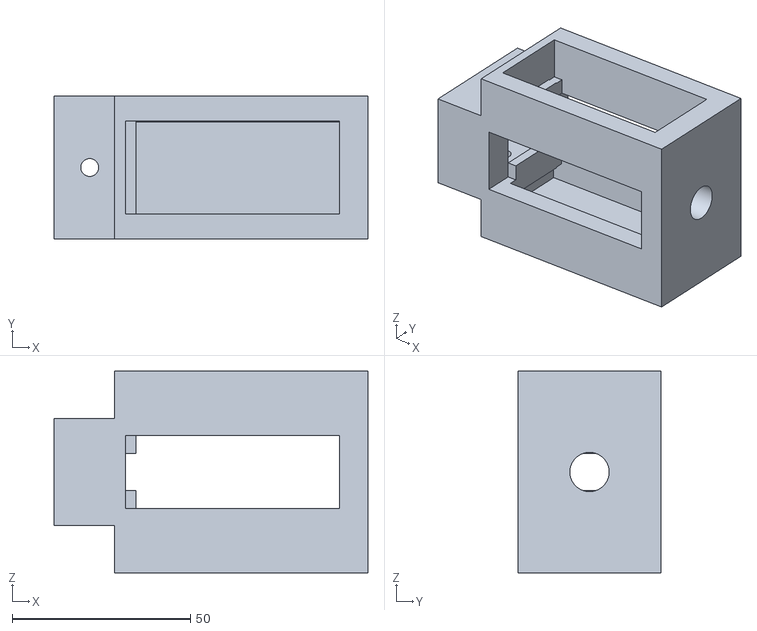
[picture p107: CAD file, 2024-06-10]
design/FreeCAD/Bin Sorter/Tensioner Mount.stl
88.0 x 40.0 x 56.5
