samin50/MEngFYP/design/FreeCAD/Camera Mount/Camera Box newstl.stl

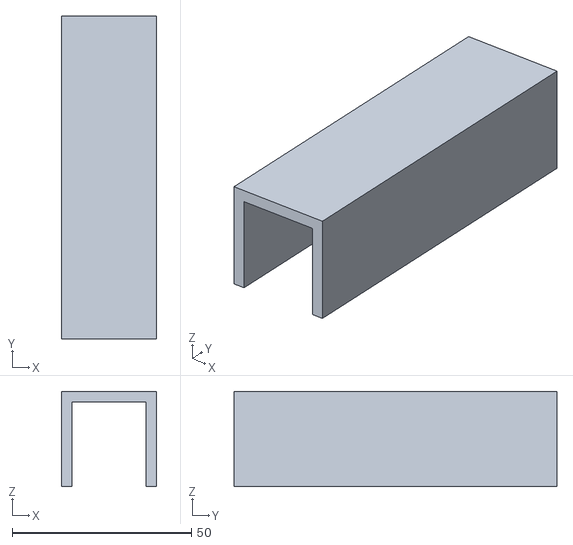
[picture p108: CAD file, 2024-06-01]
design/FreeCAD/Camera Mount/Camera Box newstl.stl
26.5 x 90.0 x 26.5
