samin50/MEngFYP/design/FreeCAD/Conveyor/Motor Driven.stl

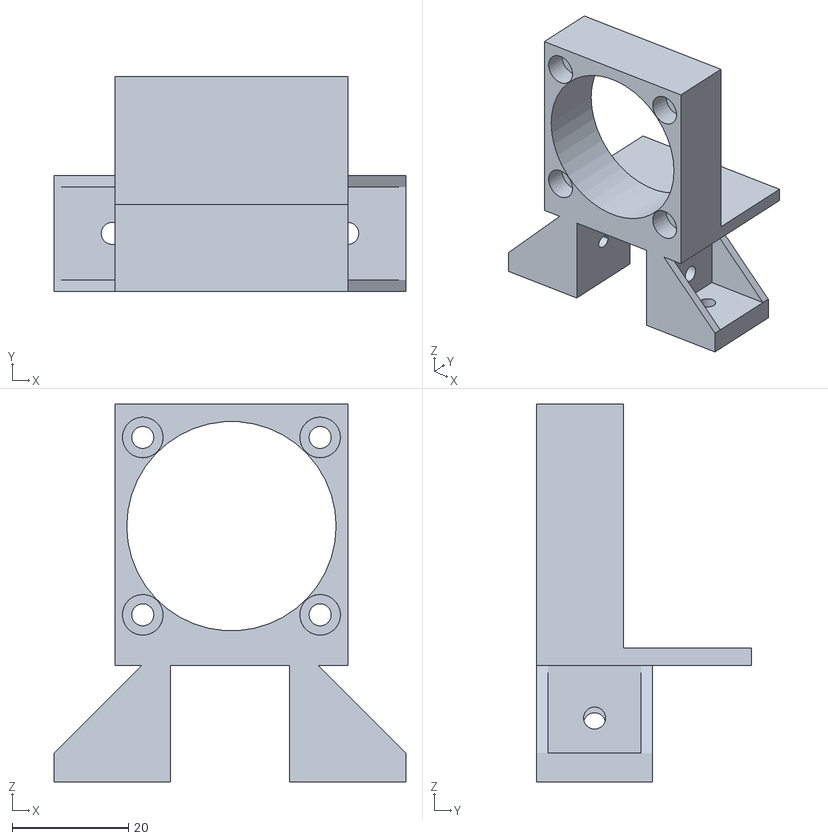
[picture p109: CAD file, 2024-06-03]
design/FreeCAD/Conveyor/Motor Driven.stl
60.5 x 37.0 x 65.0
