samin50/MEngFYP/design/FreeCAD/Conveyor/Rollers/Idle Inner Tube.stl

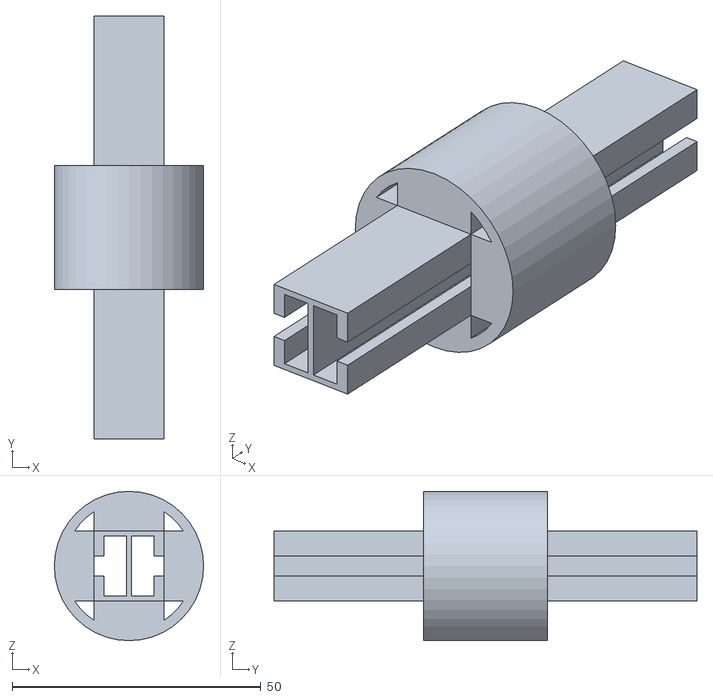
[picture p110: CAD file, 2024-04-22]
design/FreeCAD/Conveyor/Rollers/Idle Inner Tube.stl
30.0 x 85.0 x 30.0
