samin50/MEngFYP/design/FreeCAD/LCD/Screen Test Fit.stl

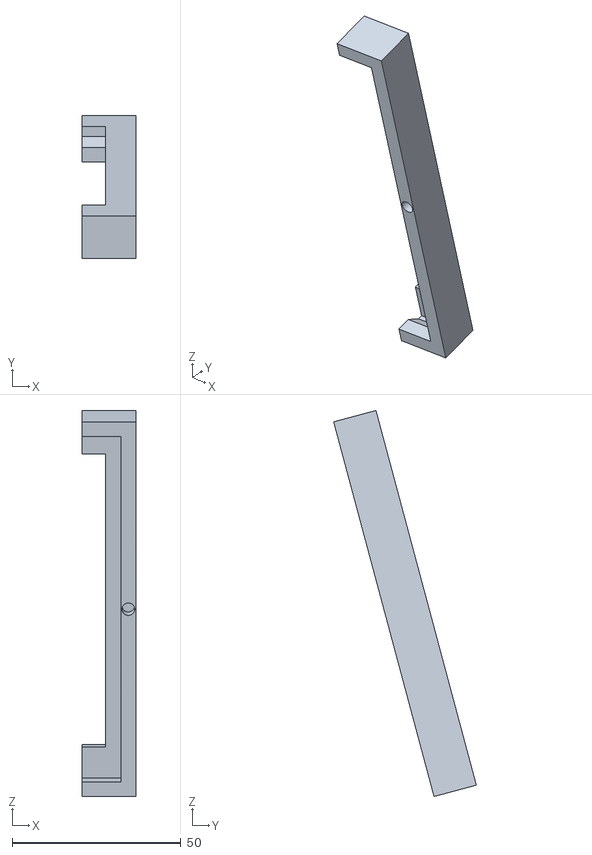
[picture p111: CAD file, 2023-12-28]
design/FreeCAD/LCD/Screen Test Fit.stl
16.0 x 42.3 x 114.4
