samin50/MEngFYP/design/FreeCAD/PSU/Switch Mount.stl

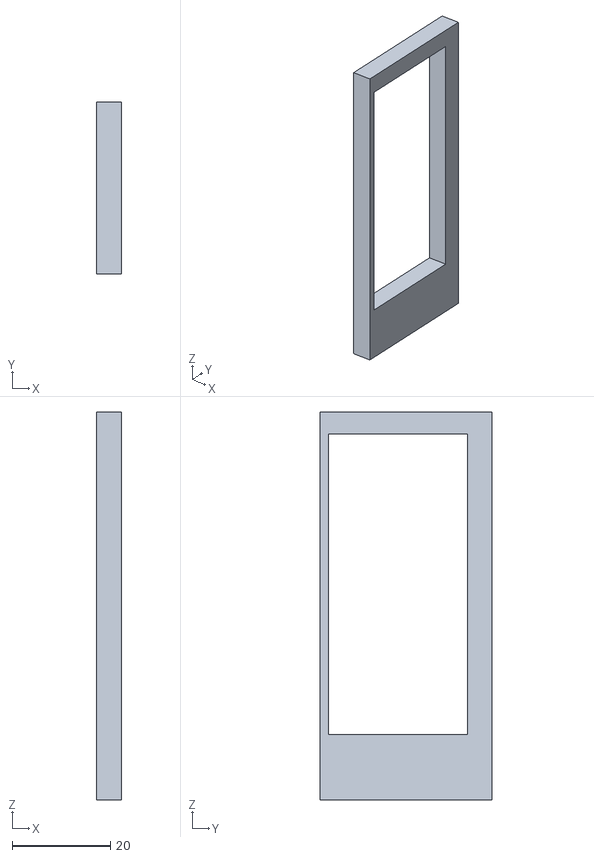
[picture p112: CAD file, 2024-04-22]
design/FreeCAD/PSU/Switch Mount.stl
5.00 x 35.0 x 79.0
