samin50/MEngFYP/design/FreeCAD/Bin Sorter/Sweeper Head.stl

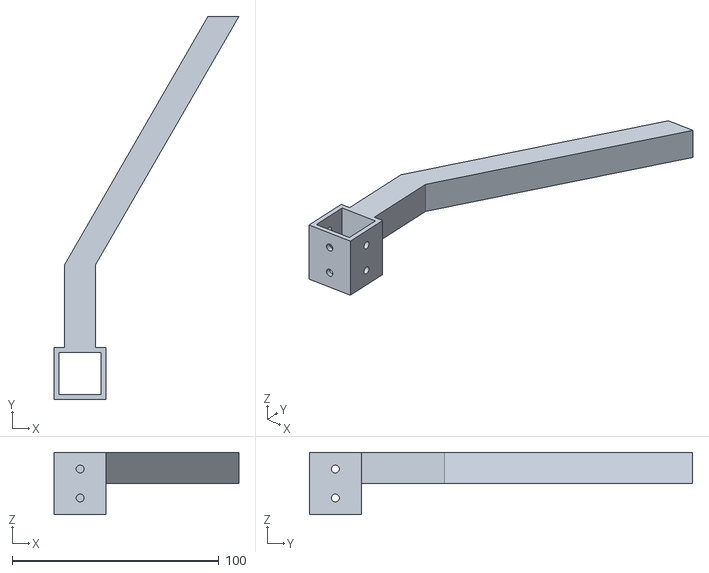
[picture p113: CAD file, 2024-05-17]
design/FreeCAD/Bin Sorter/Sweeper Head.stl
89.4 x 185.2 x 30.0
