samin50/MEngFYP/design/FreeCAD/Camera Mount/test.stl

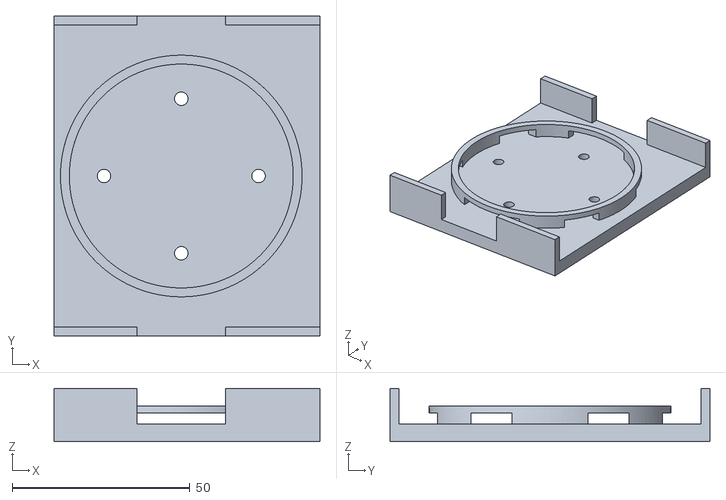
[picture p114: CAD file, 2024-04-25]
design/FreeCAD/Camera Mount/test.stl
74.9 x 90.0 x 15.0
