samin50/MEngFYP/design/FreeCAD/Conveyor/Idler Mount.stl

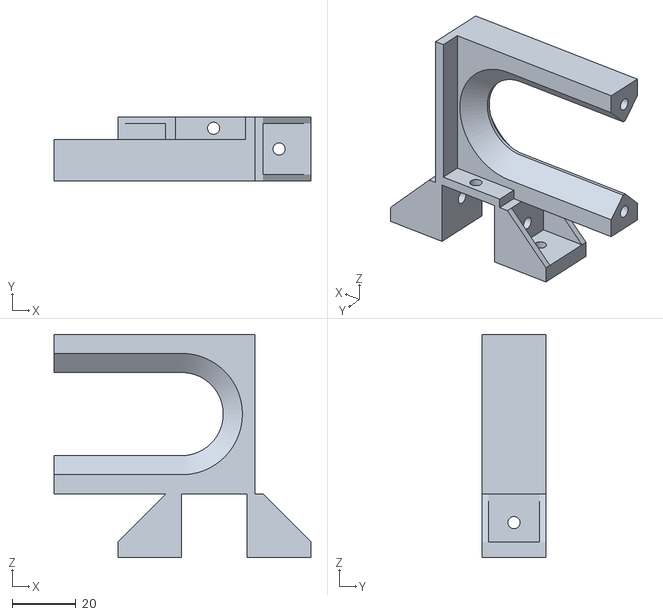
[picture p115: CAD file, 2024-06-01]
design/FreeCAD/Conveyor/Idler Mount.stl
80.5 x 20.0 x 70.0
