samin50/MEngFYP/design/FreeCAD/Conveyor/Rollers/Motor Gear.stl

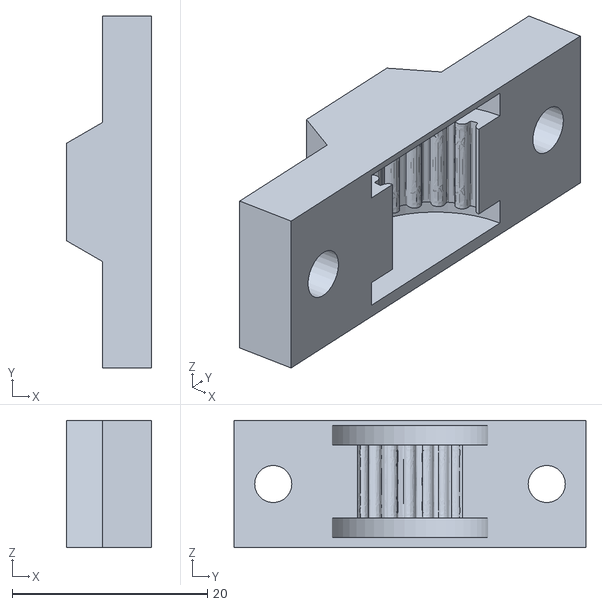
[picture p116: CAD file, 2024-04-22]
design/FreeCAD/Conveyor/Rollers/Motor Gear.stl
8.66 x 36.0 x 13.0
