samin50/MEngFYP/design/FreeCAD/PSU/PSU Switch.stl

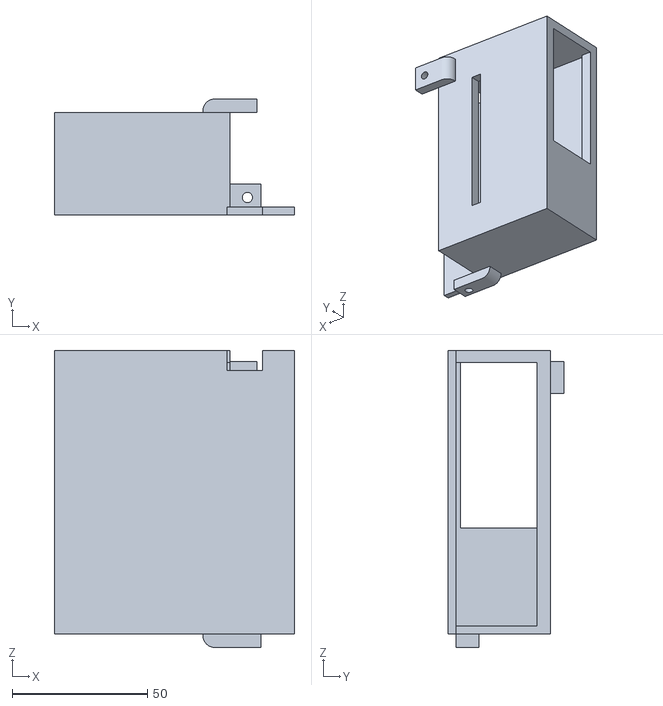
[picture p117: CAD file, 2024-04-22]
design/FreeCAD/PSU/PSU Switch.stl
89.0 x 43.0 x 110.0
