samin50/MEngFYP/design/FreeCAD/Bin Sorter/Motor Gantry Mount.stl

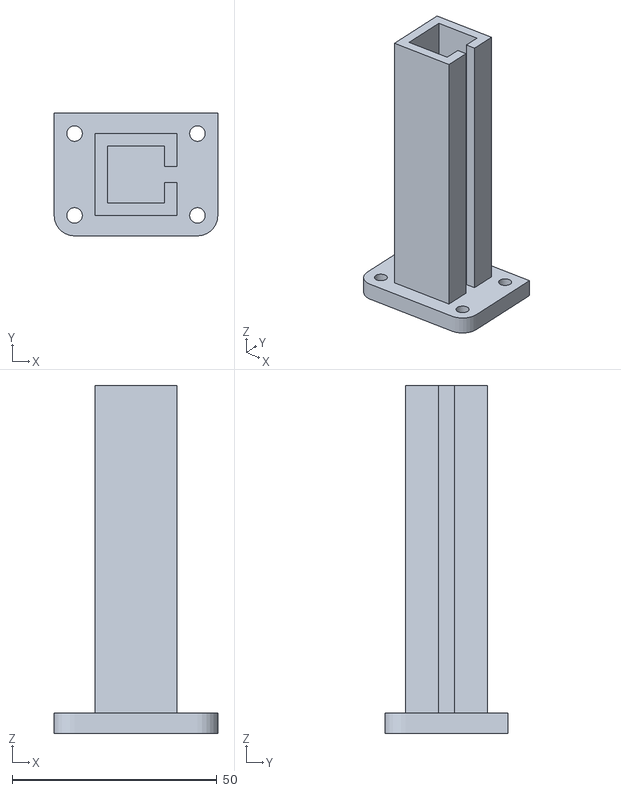
[picture p118: CAD file, 2024-05-17]
design/FreeCAD/Bin Sorter/Motor Gantry Mount.stl
40.0 x 30.0 x 85.0
