samin50/MEngFYP/design/FreeCAD/Camera Mount/Camera Corner Connector.stl

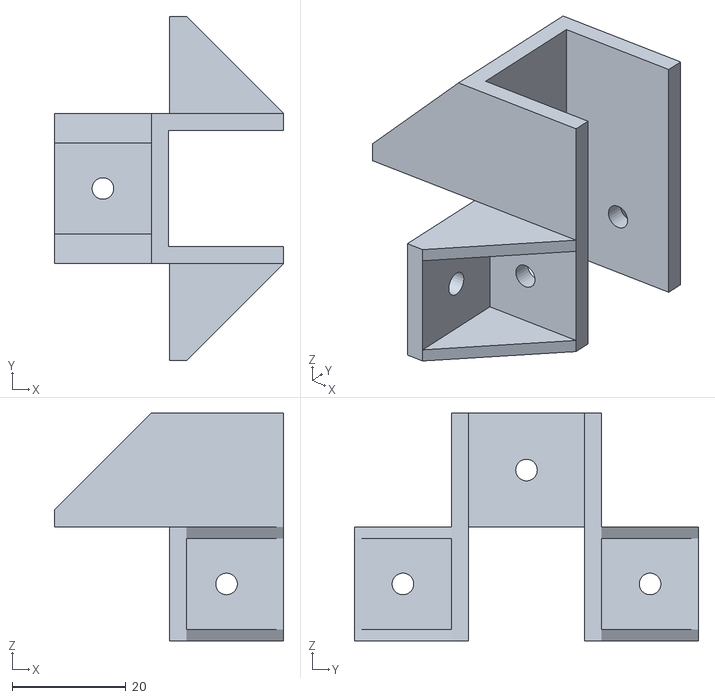
[picture p119: CAD file, 2024-04-22]
design/FreeCAD/Camera Mount/Camera Corner Connector.stl
40.2 x 60.4 x 40.0
