samin50/MEngFYP/design/FreeCAD/Conveyor/Rollers/Idle Tube Adapter.stl

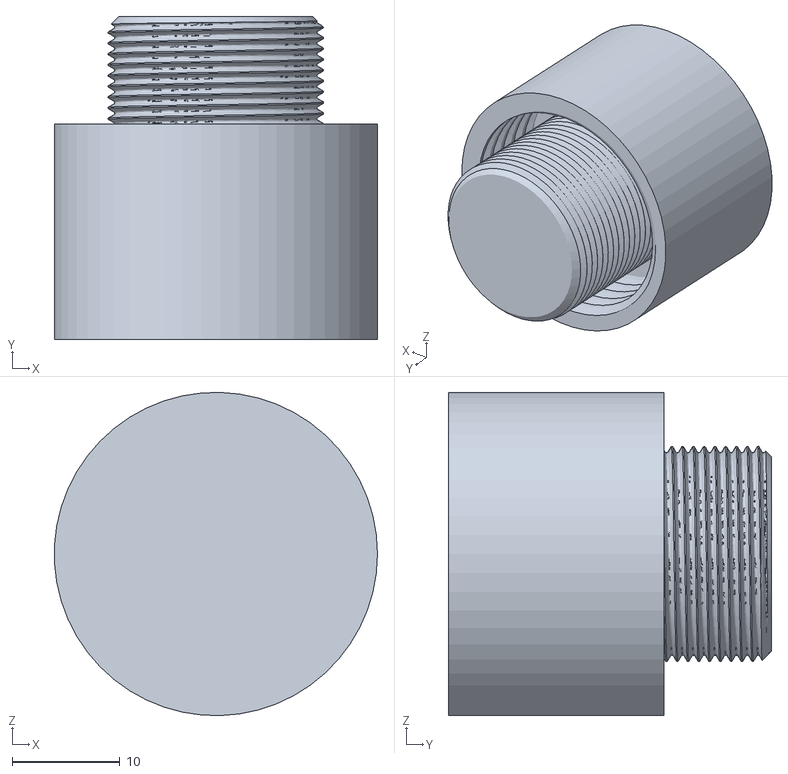
[picture p120: CAD file, 2024-04-22]
design/FreeCAD/Conveyor/Rollers/Idle Tube Adapter.stl
30.0 x 30.0 x 30.0
