samin50/MEngFYP/design/FreeCAD/PSU/Step Down Back.stl

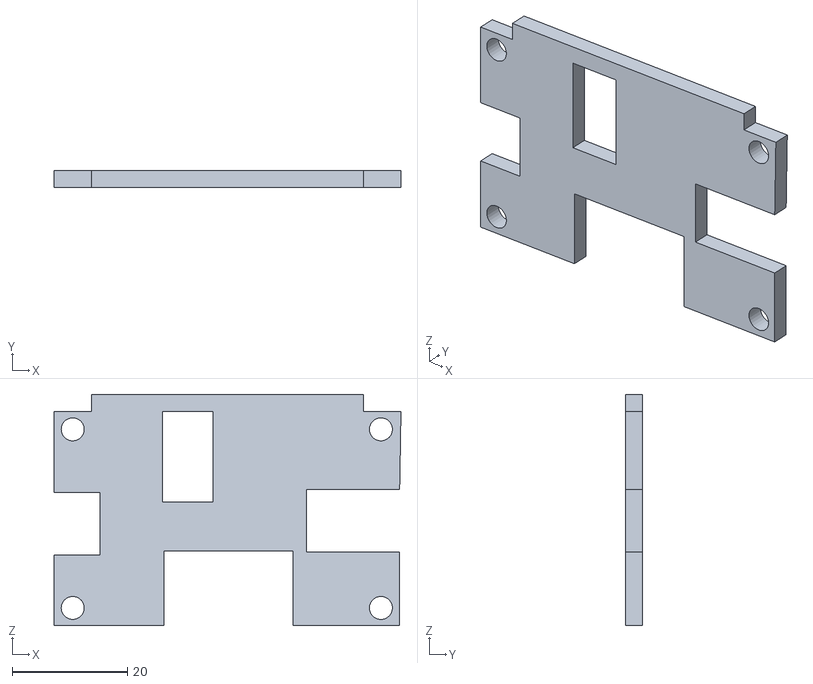
[picture p121: CAD file, 2023-12-28]
design/FreeCAD/PSU/Step Down Back.stl
60.2 x 3.00 x 40.2
