samin50/MEngFYP/design/FreeCAD/Bin Sorter/Belt Tensioner.stl

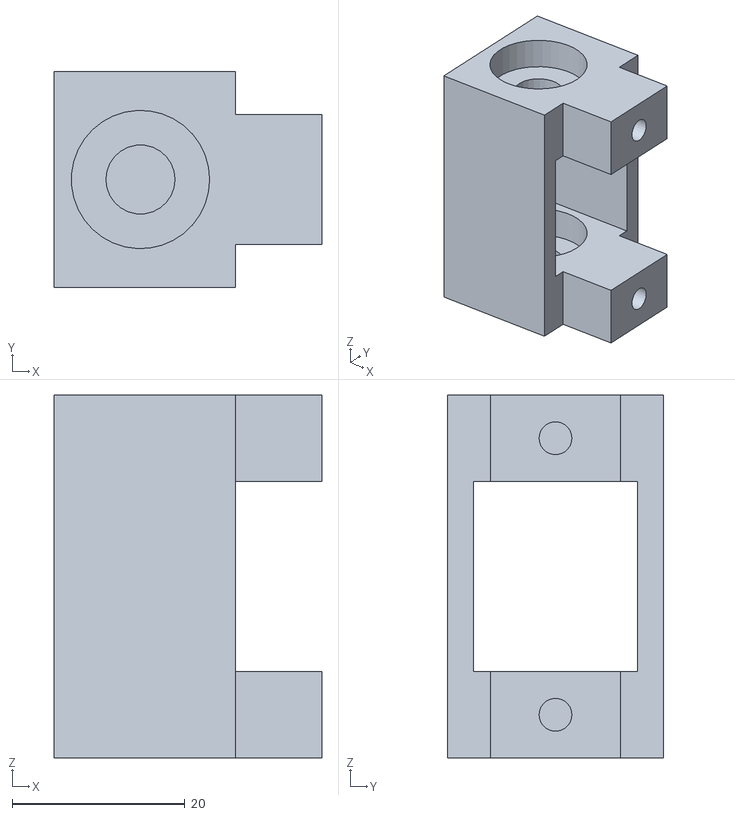
[picture p122: CAD file, 2024-05-13]
design/FreeCAD/Bin Sorter/Belt Tensioner.stl
31.0 x 25.0 x 42.0
