samin50/MEngFYP/design/FreeCAD/Conveyor/Cover.stl

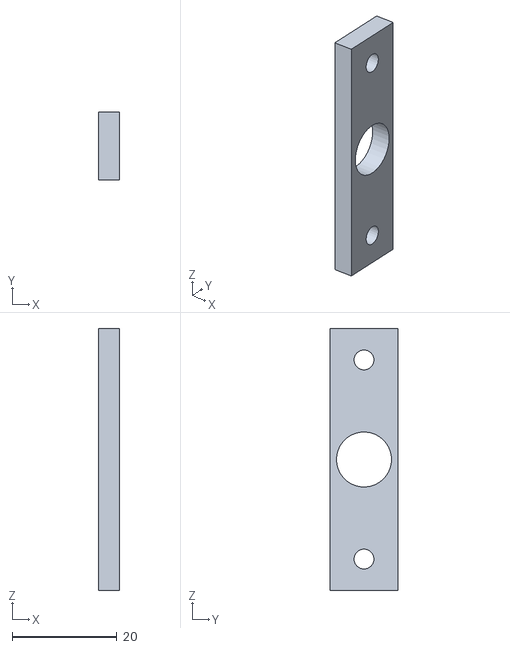
[picture p123: CAD file, 2024-04-22]
design/FreeCAD/Conveyor/Cover.stl
4.00 x 13.0 x 50.0
