samin50/MEngFYP/design/FreeCAD/PSU/PSU Fit Test.stl

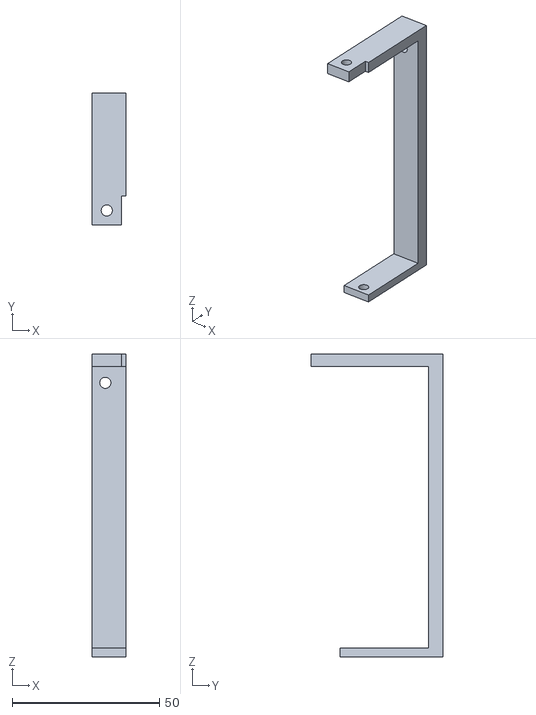
[picture p124: CAD file, 2023-12-28]
design/FreeCAD/PSU/PSU Fit Test.stl
11.5 x 45.0 x 103.0
