samin50/MEngFYP/design/FreeCAD/Conveyor/Bearing Mount.stl

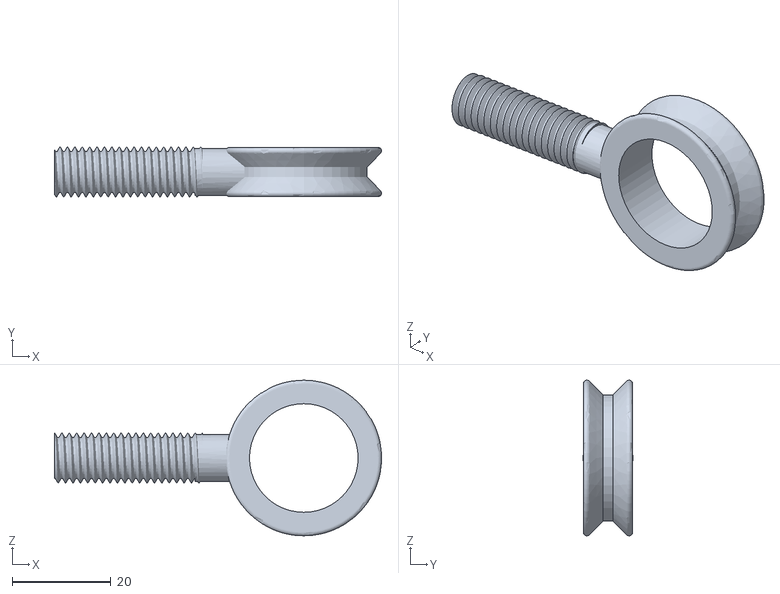
[picture p125: CAD file, 2024-04-22]
design/FreeCAD/Conveyor/Bearing Mount.stl
66.2 x 10.1 x 31.5
