samin50/MEngFYP/design/FreeCAD/PSU/PSUMount.stl

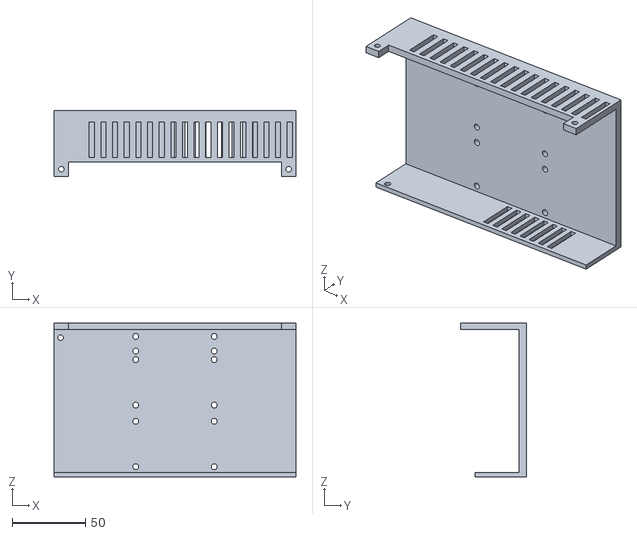
[picture p126: CAD file, 2023-12-28]
design/FreeCAD/PSU/PSUMount.stl
165.0 x 45.0 x 105.0
