samin50/MEngFYP/design/FreeCAD/Bin Sorter/Tensioner Knob.stl

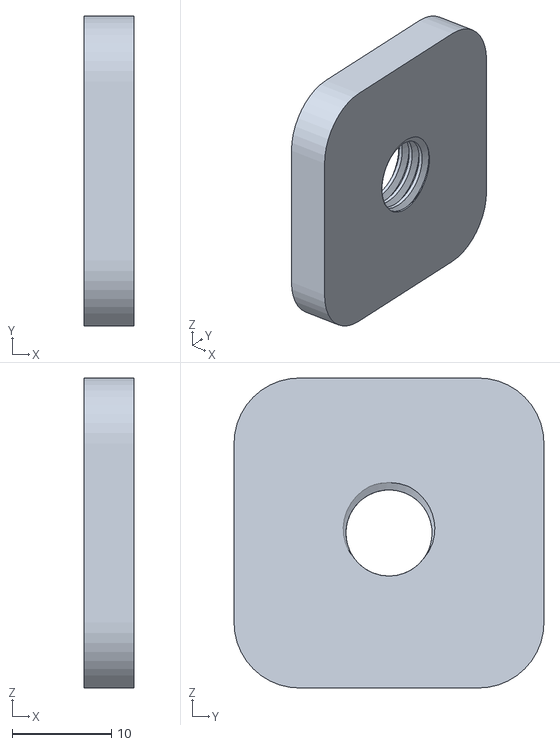
[picture p127: CAD file, 2024-05-13]
design/FreeCAD/Bin Sorter/Tensioner Knob.stl
5.00 x 31.3 x 31.3
