samin50/MEngFYP/design/FreeCAD/Conveyor/Connector.stl

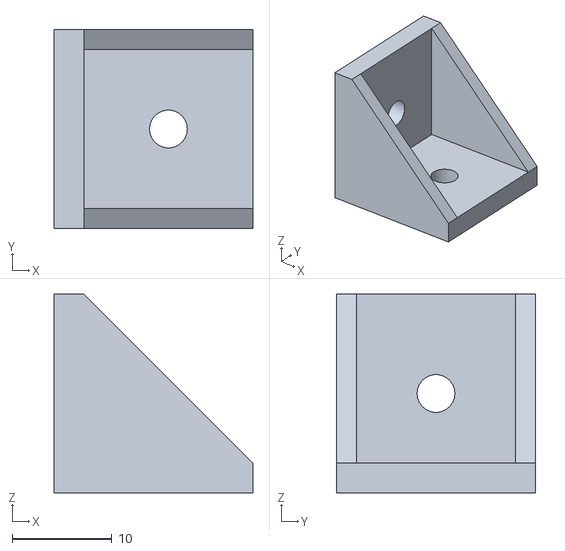
[picture p128: CAD file, 2024-04-22]
design/FreeCAD/Conveyor/Connector.stl
20.0 x 20.0 x 20.0
