samin50/MEngFYP/(list of files, cad)

Other CAD files:
design/FreeCAD/Bin Sorter/Tensioner Screw.stl
design/FreeCAD/Camera Mount/Old/Bottom Casing.stl
design/FreeCAD/Camera Mount/Old/Camera Box.stl
design/FreeCAD/Camera Mount/Old/Camera Mount.stl
design/FreeCAD/Camera Mount/Old/Diffuser.stl
design/FreeCAD/Camera Mount/Old/Light Plate.stl
design/FreeCAD/Camera Mount/Old/Middle Casing.stl
design/FreeCAD/Camera Mount/Old/Top Casing.stl
design/FreeCAD/Conveyor/Nut.stl
