samin50/MEngFYP/.kanbn/tasks/build-stage-1-system.md

---
created: 2023-12-20T03:25:22.714Z
updated: 2024-02-12T16:59:27.377Z
assigned: ""
progress: 1
tags:
  - 'Stage 1'
  - HME
  - Huge
due: 2024-02-13T00:00:00.000Z
started: 2023-12-20T00:00:00.000Z
completed: 2024-01-02T00:00:00.000Z
---

# Build Stage 1 System

Complete the Stage 1 build.
- Have the RPI
- Have the LCD
- Have the LED ring
- Mount everything properly with a 3D printed design
- Power everything with PSU

## Sub-tasks

- [x] Design camera mount
- [x] Design PSU mount
- [x] Design LCD mount
- [x] Design LED ring mount

## Relations

- [Requires design-lcd-mount](design-lcd-mount.md)
- [Requires design-psu-mount](design-psu-mount.md)
- [Requires design-camera-mount](design-camera-mount.md)
