samin50/MEngFYP/src/tests/checklist.md

### Color Checklist
Use this checklist to mark off each color as you find a resistor that includes it:

- [X] Black
- [X] Brown
- [X] Red
- [X] Orange
- [X] Yellow
- [X] Green
- [X] Blue
- [X] Violet
- [X] Gray
- [X] White
- [X] Gold (Tolerance)
- [ ] Silver (Tolerance)

### Resistor Selection Table
Record the resistor values you choose and which colors they cover in this table:

| Resistor Value | Color Bands Covered |
|---|---|
| 47 | Yellow, Violet, Black, Gold, Brown |
| 68K | Blue, Gray, Black, Red, Brown |
| 51k | Green, Brown Black, Orange, Brown |
| 3.9k | Orange, White, Black, Brown |

### Resistor Colors and Values

| Color | Resistor Values |
|---|---|
| Black (0) |  10 22 47 100 150 200 220 270 330 470 510 680 1k 2k 2.2k 3.3k 4.7k 5.1k 6.8k 10k 20k 47k 51k 68k 100k 220k 300k 470k 680k 1m |
| Brown (1) |  10 22 47 100 150 200 220 270 330 470 510 680 1k 2k 2.2k 3.3k 4.7k 5.1k 6.8k 10k 20k 47k 51k 68k 100k 220k 300k 470k 680k 1m|
| Red (2) |  22  200 220 270 2k 2.2k 10k 20k 47k 51k 68k 220k |
| Orange (3)|  330 3.3k 100k 220k 300k 470k 680k |
| Yellow (4)|  47 470 4.7k 47k 470k 1m |
| Green (5) |  150 510 5.1k 51k |
| Blue (6)  |  680 6.8k 68k 680k |
| Violet (7)|  47 270 470 4.7k 47k 470k |
| Gray (8)  |  680 6.8k 68k 680k  |
| White (9) | |
| Gold (Tolerance) | 10 22 47 100 |
| Silver (Tolerance) |  |

### Notes
- **Gray** and **White** bands are less common in typical resistor values; White is not represented here.
- **Gold** and **Silver** are used for tolerance markings and not for the main resistance value bands.
