samin50/MEngFYP/(list of files, drawings)

Other design files:
design/Fritzing/wiring.fzz
