samin50/MEngFYP/src/pi4/vision_handler.py

"""
Responsible for handling the vision system.
Hooks onto the pygame camera and performs inference.
"""
# pylint: disable=attribute-defined-outside-init
import time
import multiprocessing
import numpy
import cv2
import pygame
import pygame.camera as pycam
import pyautogui
import pygetwindow
import random
from os import listdir
from src.pi4.display_feed_pygame import CameraFeed
from src.pi4.multiprocessinghandlers import *
from src.common.helper_functions import start_ui
from src.common.constants import CAMERA_RESOLUTION, CLASSIFIER_PATH, TRAINING_MODE_CAMERA_SIZE, CAMERA_DISPLAY_SIZE, FPS_FONT_SIZE, CAMERA_FRAMERATE
from src.vision.vsrc.constants import DATA, REALVNC_WINDOW_NAME, BORDER_WIDTH, LOWER_THRESHOLD, UPPER_THRESHOLD
class Vision_Handler:
    def __init__(self, enableInference:bool=True):
        self.enableInference = enableInference
        self.lcdCallbacks = {}

    def init(self, cameraDisplay:pygame.display, componentDisplay:pygame.display, trainingMode:bool=False, captureVNC:bool=False, enableKeyboard:bool=False) -> None:
        """
        Initialise the vision handler
        """
        self.startTime = time.time()
        # Constants
        self.resolution = TRAINING_MODE_CAMERA_SIZE if trainingMode else CAMERA_DISPLAY_SIZE
        self.trainingMode = trainingMode
        self.captureVNC = captureVNC
        self.enableKeyboard = enableKeyboard
        self.forceImage = False
        # Surface setup
        self.cameraDisplay = cameraDisplay
        self.componentDisplay = componentDisplay
        self.imgDisplay = pygame.Surface(CAMERA_RESOLUTION)
        self.obbDisplay = pygame.Surface(CAMERA_RESOLUTION)
        self.obbDisplay.set_colorkey((0, 0, 0))
        self.currentFrame = pygame.Surface(CAMERA_RESOLUTION)
        self.resizedFrame = pygame.Surface(self.resolution)
        # Camera setup
        self.cameraFeed = CameraFeed(self.cameraDisplay, trainingMode)
        # Class label font
        self.labelMap = {k["num_label"] : k["label"] for k in DATA.values()}
        # FPS
        self.fpsFont = pygame.font.SysFont("Roboto", FPS_FONT_SIZE)
        self.fps = self.fpsFont.render("FPS: 0", True, (255,255,255))
        self.cameraclock = pygame.time.Clock()
        self.drawFPSEvent = pygame.USEREVENT + 100
        pygame.time.set_timer(self.drawFPSEvent, 1000 // CAMERA_FRAMERATE)
        pycam.init()
        # Inference and locks
        self.doInference = multiprocessing.Event()
        self.constInference = multiprocessing.Event()
        self.busyInference = multiprocessing.Event()
        self.frameQueue = multiprocessing.Queue(maxsize=1)
        self.resultQueue = multiprocessing.Queue(maxsize=1)
        modelPath = CLASSIFIER_PATH if self.enableInference else None
        if self.enableInference:
            modelPath = CLASSIFIER_PATH
            self.inferenceProcess = multiprocessing.Process(target=inference_process, args=(self.frameQueue, self.resultQueue, self.busyInference, modelPath), daemon=True)
            self.inferenceProcess.start()
        return self

    def force_image(self) -> None:
        """
        Force an image to be displayed
        """
        self.forceImage = True

    def stop_force_image(self) -> None:
        """
        Unforce the image
        """
        self.forceImage = False

    def set_image(self, imagePath:str) -> None:
        """
        Set the image to be displayed
        """
        self.imgDisplay = pygame.image.load(imagePath)

    def set_lcd_callbacks(self, callbacks:dict) -> None:
        """
        Set the LCD callbacks
        """
        self.lcdCallbacks = callbacks

    def update_frame(self) -> pygame.Surface:
        """
        Get the current frame from the camera
        """
        _ = self.cameraclock.tick(CAMERA_FRAMERATE) / 1000.0
        # Get the frame
        self.currentFrame = self.get_frame()
        self.currentFrame.blit(self.obbDisplay, (0,0))
        # Resize the frame and draw FPS in the bottom right corner
        if not self.trainingMode:
            self.resizedFrame = pygame.transform.scale(self.currentFrame, self.resolution)
            self.resizedFrame.blit(self.fps, (self.resolution[0]-(self.fps.get_width()+5), self.resolution[1]-(self.fps.get_height())))
        else:
            padding = 10
            self.resizedFrame = pygame.transform.scale(self.currentFrame, (self.resolution[0]-padding, self.resolution[1]-padding))
            backgroundFrame = pygame.Surface(self.resolution)
            backgroundFrame.fill((255, 0, 255))
            backgroundFrame.blit(self.resizedFrame, (padding//2, padding//2))
            self.resizedFrame = backgroundFrame
        # Draw the frame
        self.cameraDisplay.blit(self.resizedFrame, (0,0))

    def event_handler(self, event:pygame.event.Event) -> None:
        """
        Handle pygame events
        """
        if event.type == self.drawFPSEvent:
            self.update_frame()
            self.fps = self.fpsFont.render(f"FPS: {self.cameraclock.get_fps():.0f}", True, (255,255,255))
        if event.type == pygame.KEYDOWN and self.enableKeyboard:
            if event.key == pygame.K_i:
                print("Inference once")
                self.doInference.set()
            if event.key == pygame.K_c:
                if self.constInference.is_set():
                    print("Inference off")
                    self.constInference.clear()
                else:
                    print("Inference on")
                    self.constInference.set()
            if event.key == pygame.K_f:
                self.forceImage = not self.forceImage
                print(f"Force image: {self.forceImage}")
            if event.key == pygame.K_v:
                self.captureVNC = not self.captureVNC
                print(f"Capture VNC: {self.captureVNC}")
            if event.key == pygame.K_r:
                # Select random file
                filePath = "./datasets/full/current/images/train"
                files = listdir(filePath)
                randomFile = random.choice(files)
                self.set_image(f"{filePath}/{randomFile}")
                print("Random image selected")

    def set_do_inference(self) -> None:
        """
        Set the do inference flag
        """
        self.doInference.set()

    def set_const_inference(self, constInference:bool) -> None:
        """
        Set the constant inference flag
        """
        if constInference:
            self.constInference.set()
        else:
            self.constInference.clear()

    def get_frame(self) -> pygame.Surface:
        """
        Get the current frame
        """
        # Capture the frame
        if self.captureVNC:
            frame = self.capture_vnc()
        elif self.forceImage:
            frame = self.imgDisplay.copy()
        else:
            frame = self.cameraFeed.get_frame()
        # Perform inference
        if self.enableInference:
            # Consume the result
            if not self.resultQueue.empty():
                dis, croppedImage, conf, cls = self.resultQueue.get()
                endTime = time.time()
                # Update the inference time
                self.lcdCallbacks.get("update_inference_time", lambda _: None)(endTime-self.startTime)
                self.lcdCallbacks.get("update_confidence", lambda _: None)(conf)
                self.lcdCallbacks.get("update_class", lambda _: None)(cls)
                self.obbDisplay = pygame.surfarray.make_surface(dis)
                self.obbDisplay.set_colorkey((0, 0, 0))
                if croppedImage is not None:
                    croppedImage = pygame.surfarray.make_surface(croppedImage)
                    croppedImage = pygame.transform.scale(croppedImage, (self.resolution[0]//3, self.resolution[1]))
                    self.componentDisplay.blit(croppedImage, (0,0))
            # Produce a frame
            if (self.doInference.is_set() or self.constInference.is_set()) and not self.busyInference.is_set():
                self.busyInference.set()
                if self.frameQueue.empty():
                    self.startTime = time.time()
                    self.frameQueue.put(pygame.surfarray.array3d(frame).swapaxes(0,1))
                    self.doInference.clear()
        return frame

    def capture_vnc(self) -> None:
        """
        Capture an image from the Raspberry Pi.
        """
        # Focus on the RealVNC window
        try:
            realVNCWindow = pygetwindow.getWindowsWithTitle(REALVNC_WINDOW_NAME)[0]
            realVNCWindow.activate()
        except:
            return self.currentFrame
        # Capture the image
        screenshotPil = pyautogui.screenshot(region=(realVNCWindow.left, realVNCWindow.top, realVNCWindow.width, realVNCWindow.height))
        # Convert to OpenCV format
        screenshotCv = numpy.array(screenshotPil)
        # Find the contours defined by the pink square
        mask = cv2.inRange(cv2.cvtColor(screenshotCv, cv2.COLOR_BGR2HSV), LOWER_THRESHOLD, UPPER_THRESHOLD)
        contours, _ = cv2.findContours(mask, cv2.RETR_TREE, cv2.CHAIN_APPROX_SIMPLE)
        if contours:
        # Find the largest contour in the mask
            largestContour = max(contours, key=cv2.contourArea)
            x, y, w, h = cv2.boundingRect(largestContour)
            x, y, w, h = x+BORDER_WIDTH, y+BORDER_WIDTH, w-(BORDER_WIDTH*2), h-(BORDER_WIDTH*2)
            cameraRegion = screenshotCv[y:y+h, x:x+w]
            surface = pygame.surfarray.make_surface(cv2.cvtColor(cameraRegion, cv2.COLOR_BGR2RGB))
            surface = pygame.transform.flip(surface, True, False)
            surface = pygame.transform.rotate(surface, 90)
            return surface
        return self.currentFrame

    def destroy(self) -> None:
        """
        Destroy the camera
        """
        if self.realCamera is not None:
            self.realCamera.stop()
        return

if __name__ == "__main__":
    INFERENCE = True
    CAPTURE_VNC = False
    TRAINING_MODE = False
    ENABLE_KEYBOARD = True
    CAMERA_FRAMERATE = 30
    pygame.init()
    pygame.display.set_caption("Vision Handler")
    clk = pygame.time.Clock()
    display = pygame.display.set_mode((CAMERA_RESOLUTION[0]//3+CAMERA_RESOLUTION[0], CAMERA_RESOLUTION[1]), 0)
    camera = pygame.Surface((CAMERA_RESOLUTION[0], CAMERA_RESOLUTION[1]))
    compDisplay = pygame.Surface((CAMERA_RESOLUTION[0]//3, CAMERA_RESOLUTION[1]))
    vision = Vision_Handler(INFERENCE).init(camera, compDisplay, TRAINING_MODE, CAPTURE_VNC, ENABLE_KEYBOARD)
    start_ui(
        loopConditionFunc=lambda: True,
        loopFunction=[lambda: display.blit(camera, (0,0)), lambda: display.blit(compDisplay, (CAMERA_RESOLUTION[0], 0))],
        eventFunction=[vision.event_handler],
        exitFunction=[],
        clock=clk,
        framerate=CAMERA_FRAMERATE
    )
