samin50/MEngFYP/src/tests/led_test.py

#include all necessary packages to get LEDs to work with Raspberry Pi
import time
import board
import neopixel

#Initialise a strips variable, provide the GPIO Data Pin
#utilised and the amount of LED Nodes on strip and brightness (0 to 1 value)
pixels1 = neopixel.NeoPixel(board.D18, 10, brightness=1)

#Also create an arbitrary count variable
x=0

#Focusing on a particular strip, use the command Fill to make it all a single colour
#based on decimal code R, G, B. Number can be anything from 255 - 0. Use an RGB Colour
#Code Chart Website to quickly identify the desired fill colour.
pixels1.fill((0, 220, 0))

#Below demonstrates how to individual address a colour to a LED Node, in this case
#LED Node 10 and colour Blue was selected
pixels1[5] = (0, 20, 255)

#Sleep for three seconds, You should now have all LEDs showing light with the first node
#Showing a different colour
time.sleep(4)

#Little Light slider script, will produce a nice loading bar effect that goes all the way up a small Strip 
#and then all the way back
#This was created using a While Loop taking advantage of that arbitrary variable to determine
#which LED Node we will target/index with a different colour

#Below will loop until variable x has a value of 35
while x<35:
    
    pixels1[x] = (255, 0, 0)
    pixels1[x-5] = (255, 0, 100)
    pixels1[x-10] = (0, 0, 255)
    #Add 1 to the counter
    x=x+1
    #Add a small time pause which will translate to 'smoothly' changing colour
    time.sleep(0.05)

#Below section is the same process as the above loop just in reverse
while x>-15:
    pixels1[x] = (255, 0, 0)
    pixels1[x+5] = (255, 0, 100)
    pixels1[x+10] = (0, 255, 0)
    x=x-1
    time.sleep(0.05)

#Add a brief time delay to appreciate what has happened    
time.sleep(4)

#Complete the script by returning all the LED to off
pixels1.fill((0, 0, 0))
