samin50/MEngFYP/(commit log)

2023-11-10 Add more components to BOM
    [BOM.xlsx]
2023-12-18 Complete Light and Camera Mount
    [BOM.xlsx, Camera Mount.stl, Light Plate.stl, RPi and Camera.FCStd]
2023-12-20 add to BOM and add camera test
    [BOM.xlsx]
2023-12-22 Design PSU mount
    [Component Sorter.FCStd, RPi and Camera.FCStd]
2023-12-23 Setup report and finish first version of stage 1 components
    [Component Sorter.FCStd]
2023-12-28 Add report sections, finish first stage mechanics
    [Bottom Casing.stl, Component Sorter.FCStd, Middle Casing.stl, PSU Fit Test.stl, PSUMount.stl, Screen Cover.stl, Screen Support.stl, Screen Test Fit.stl]
2024-01-01 Add more to BOM, increase camera cover height
    [BOM.xlsx, Component Sorter.FCStd, Middle Casing.stl, Screen Cover.stl, Screen Support.stl]
2024-01-01 Develop slow tkinter app for showing camera feed
2024-01-01 Convert and commit to pygame with threaded camera stream and fix startup script
    [constants.py, display_feed_pygame.py, helper_functions.py, lcd_ui.py, main.py]
2024-01-02 Add diffuser
    [Component Sorter.FCStd]
2024-01-03 Begin vision system data collection, add resistor categoriser, fix windows launch config
    [constants.py, main.py]
2024-01-10 Add labelling to vision helper
    [Component Sorter.FCStd, Diffuser.stl, Switch Mount.stl]
2024-01-22 Add to report
    [Component Sorter.FCStd, PSU Switch.stl]
2024-01-23 add some background
    [wiring.fzz]
2024-02-09 Conveyor belt design foundation
    [Component Sorter.FCStd]
2024-02-10 Belt tensioner
2024-02-12 Add to kanbn boarfd
    [Bearing Mount.stl, Connector.stl, Cover.stl, Idler Mount.stl, Motor Driven.stl, Motor Non Driven.stl, Nut.stl]
2024-04-20 Conveyor design files
    [Bottom Casing.stl, Camera Box.stl, Camera Corner Connector.stl, Camera Mount.stl, Diffuser.stl, Idle End Adapter.stl, Idle Inner Tube.stl, Idle Tube Adapter.stl]
2024-04-22 motor pin definitions
    [wiring.fzz]
2024-04-22 add wifi button
2024-04-25 Start final report
    [Camera Box.stl, Mount Plate.stl, test.stl]
2024-04-30 Old conveyor design
    [Camera Box.stl, Idle End Adapter.stl, Motor Coupler.stl]
2024-05-01 Begin work on vision
    [Idle End Adapter.stl, Motor Non Driven.stl, Mount Plate.stl]
2024-05-03 weird issue with packages
    [Camera Box.stl, Component Sorter.FCStd, Idler Mount.stl]
2024-05-03 Disable crash on camera disconnect
    [display_feed_pygame.py]
2024-05-04 Neopixel SPI controls
2024-05-04 try to identify spi bug
    [main.py, mechanics_controller.py]
2024-05-05 transition to direct control LED
2024-05-05 complete threaded led strip
2024-05-06 try to fix spi bug
    [lcd_ui.py, mechanics_controller.py]
2024-05-13 Sweeping head model
    [Belt Tensioner.stl, Bottom Casing.stl, Camera Mount.stl, Gantry.stl, Idler Mount.stl, Light Plate.stl, Middle Casing.stl, Motor Driven.stl]
2024-05-17 add snapshot button
2024-05-17 update rpi builder, begin developing obb builder
    [Blocker.stl, Container.stl, Motor Gantry Mount.stl, Rail.stl, Sweeper Head.stl]
2024-05-23 Create resistor band annotator
2024-05-24 finish resistor labelliing
2024-05-27 seperate camera functionality into vision handler
2024-05-30 update PSU cover
    [Bin Container.stl, Bin Extrusion Mount.stl, Extrusion Mount.stl, Screen Cover.stl, Screen Support.stl, USB Ports.stl]
2024-06-01 initial version of system controller
    [Bin Container.stl, Bottom Casing.stl, Camera Box newstl.stl, Camera Box.stl, Camera Mount.stl, Idler Mount.stl, Light Plate.stl, Middle Casing.stl]
2024-06-03 start on report
    [Motor Driven.stl, Motor Non Driven A.stl, Motor Non Driven B.stl, Motor Non Driven.stl, Screen Support.stl]
2024-06-09 fix start up crashes
    [Bin Container.stl, Bin Extrusion Mount.stl]
2024-06-10 fix trainer begin writting about cv
    [Tensioner Mount.stl]
2024-06-12 prepare to integrate vision
    [wiring.fzz]
2024-06-13 ready to adjust ui slightly
    [Camera Box.stl]
2024-06-14 save progress
    [Mount Plate.stl]
2024-06-17 about to rewrite controllers
    [Gantry.stl, Motor Mount.stl]
